fdelconte/RadioInti_M4/README.md

# RadioInti_M4

- [x] checkeado
- [ ] no checked
