fdelconte/RadioInti_M4/HW/Datasheets/Donde comprar los componentes.txt

NE5532D8 -> GM
NE5534D  -> GM

STM32F4Discovery -> Elemon
