fdelconte/RadioInti_M4/HW/Radios_Comunitarias.xls

Comment | Proveedor | Cod. Proveedor | Encapsulado | Designator | Footprint | LibRef | Quantity
10uF 25V T | Elemon | CA3389022K | SMD, TAJ_C | C1, C2, C6, C9, C11, C19, C24, C27, C30, C35, C38, C52, C61, C76, C85, C87 | TAJ_CodeC | CapaPol | 16
0.1uF 25V X7R | Elemon | CA3289100 | 0603 | C3, C4, C7, C8, C13, C14, C20, C21, C26, C31, C32, C37, C55, C57, C79, C81, C88 | C_0603 | Capacitor | 17
1000UF 16V E | Elemon | CA3609183 | TH-10x16 | C5, C10 | Capael_10x16 RAD | CapaPol | 2
330uF 25V T | Elemon | CA3629155 | SMD | C12 | CAPAEL_8x10_SMD | CapaPol | 1
47uF 16V T | Elemon | CA3389030 | TANT_D | C15, C16, C18, C25, C29, C36, C40, C42, C51, C54, C64, C66, C75, C78 | TAJ_CodeD | CapaPol | 14
470pF 50V X7R | Elemon | CA3288970 | 0603 | C17, C23, C28, C34 | C_0603 | Capacitor | 4
10nF 25V X7R | Elemon | CA3289050 | 0603 | C22, C33 | C_0603 | Capacitor | 2
3.3nF 50V X7R | Elemon | CA3279250 | 0805 | C39, C50, C63, C74 | C_0805 | Capacitor | 4
1.2nF 50V COG | Elemon | CA3279110 | 0805 | C41, C46, C53, C59, C65, C70, C77, C83 | C_0805 | Capacitor | 8
1.5nF 50V X7R | Elemon | CA3279140 | 0805 | C43, C58, C67, C82 | C_0805 | Capacitor | 4
1nF 100V X7R | Elemon | CA3289030 | 0603 | C44, C49, C68, C73 | C_0603 | Capacitor | 4
100pF 50V COG | Elemon | CA3288850 | 0603 | C45, C47, C48, C56, C60, C62, C69, C71, C72, C80, C84, C86 | C_0603 | Capacitor | 12
Bornera P2.54mm | Elemon | Consultar |  | CN1 | Conn_3_1 | Conn_3_1 | 1
AC3FDZ Amphenol |  |  |  | CN2, CN3 | XLR_Ext | XLR_hembra | 2
Conector 5x1 P2.54mm | Elemon | CO4901010 |  | CN4 | Conn_5_1 | Conn_5_1 | 1
MBR140SFT1G | Elemon | DI1351306 | SOD-123FL | D1, D2, D5 | SOD-123FL | Schottky | 3
TVS 36V 600W | Elemon | DI120SMDDIK36AT3G | SMB | D4, D6 | SMB | TVS | 2
IND EMI SUP FILT HAS | Elemon | FI151VINBOB600 | DSS6_S | F1, F2 | EMIFIL_DSS6_S | EMI_3T | 2
Jumper 2x1 | Elemon | CO4921360 |  | JP1, JP2, JP3, JP4 | Conn_2_1 | Jumper 2x1 | 4
Jumper 3x1 | Elemon | CO4921360 |  | JP5 | Conn_3_1 | Jumper 3x1 | 1
CHIP FERRITE BEAD | Elemon | FI1488955 | 0805 | L1 | C_0805 | Inductor | 1
JK60-300 | Elemon | TE2627680 | TH | P1, P2 | JK60-300 | Poly | 2
Hembra BNC a chasis | Elemon | Consultar |  | P3, P4 | BNC_Ext | BNC | 2
10R 5% 1/16W | Elemon | RS3866060 | 0603 | R3, R4, R5, R6 | R_0603 | Resistor | 4
4K7 5% 1/16W | Elemon | RS3866225 | 0603 | R7, R8, R14, R15, R23, R24, R37, R38 | R_0603 | Resistor | 8
47K 5% 1/16W | Elemon | RS3866285 | 0603 | R9, R16 | R_0603 | Resistor | 2
3K3 5% 1/10W | Elemon | RS3896215 | 0805 | R10, R11, R17, R18 | R_0805 | Resistor | 4
1K 5% 1/16W | Elemon | RS3866185 | 0603 | R12, R13, R19, R20 | R_0603 | Resistor | 4
1K8 5% 1/10W | Elemon | RS3896200 | 0805 | R21, R22, R26, R28, R29, R31, R35, R36, R40, R42, R43, R45 | R_0805 | Resistor | 12
1K2 5% 1/10W | Elemon | RS3896190 | 0805 | R25, R30, R39, R44, R54, R65, R71, R82 | R_0805 | Resistor | 8
22R 5% 1/16W | Elemon | RS3866085 | 0603 | R27, R33, R41, R47 | R_0603 | Resistor | 4
10K 5% 1/16W | Elemon | RS3866245 | 0603 | R32, R34, R46, R48, R51, R63, R68, R80 | R_0603 | Resistor | 8
330R 5% 1/10W | Elemon | RS3896155 | 0805 | R49, R61, R66, R78 | R_0805 | Resistor | 4
180R 5% 1/10W | Elemon | RS3896140 | 0805 | R50, R62, R67, R79 | R_0805 | Resistor | 4
680R 5% 1/10W | Elemon | RS3896175 | 0805 | R52, R64, R69, R81 | R_0805 | Resistor | 4
560R 5% 1/10W | Elemon | RS3896170 | 0805 | R53, R60, R70, R77 | R_0805 | Resistor | 4
150R 5% 1/10W | Elemon | RS3896135 | 0805 | R55, R57, R72, R74 | R_0805 | Resistor | 4
470R 5% 1/16W | Elemon | RS3866165 | 0603 | R56, R58, R73, R75 | R_0603 | Resistor | 4
100R 5% 1/16W | Elemon | RS3866125 | 0603 | R59, R76 | R_0603 | Resistor | 2
LM1117DTX-3.3/NOPB | Elemon | CI2707214D | DPAK, SMD | U1, U4 | DPAK | LM1117 | 2
LM7805CDT | Elemon | CI2707459 | TO-220-3 | U2, U3 | TO-220-3 | LM7805 | 2
TL072 | SYC | TL072-SMD | SOIC8 | U5, U6, U7, U8, U9, U10, U11, U12 | SOIC8 | NE5532D8 | 8
STM32F4Discovery | Elemon | MC6350305 | TH | U13 | STM32F4DISCOVERY | STM32F4Discovery | 1
AK4621 | Ya esta | Ya esta | SMD | U14 | AK4621 | AK4621 | 1
