fdelconte/RadioInti_M4/HW/Radios_Comunitarias.PDF

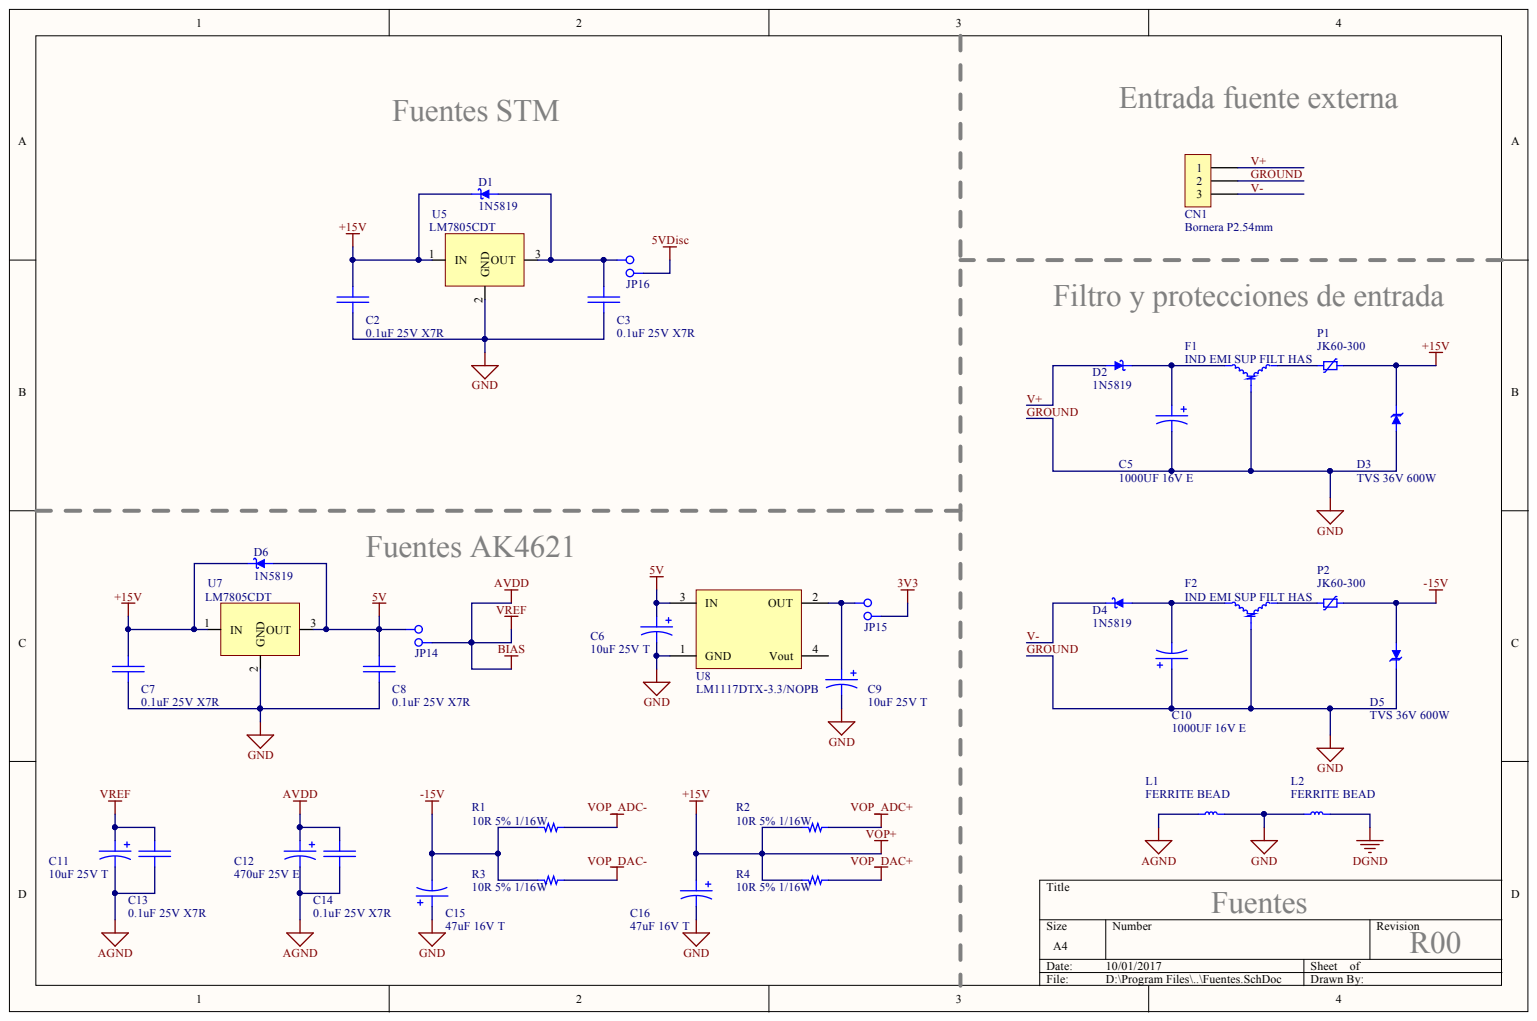
[picture p3: page 1]

Entrada fuente externa Fuentes STM

Filtro y protecciones de entrada

IND EMI SUP FILT HAS

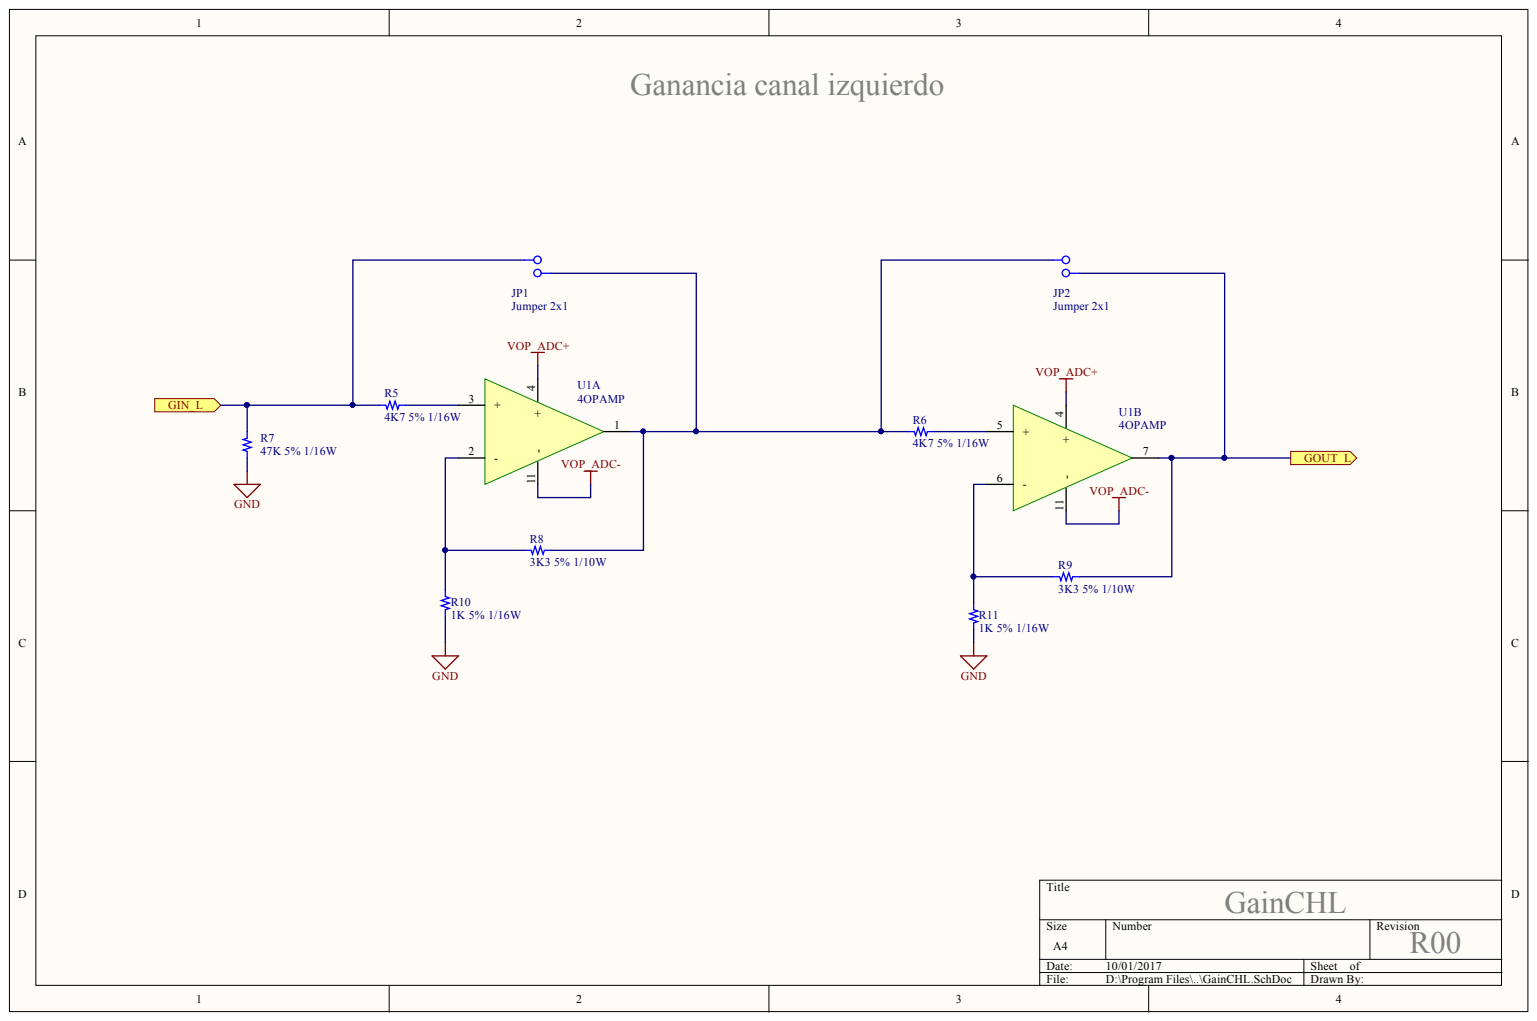
[picture p4: page 2]

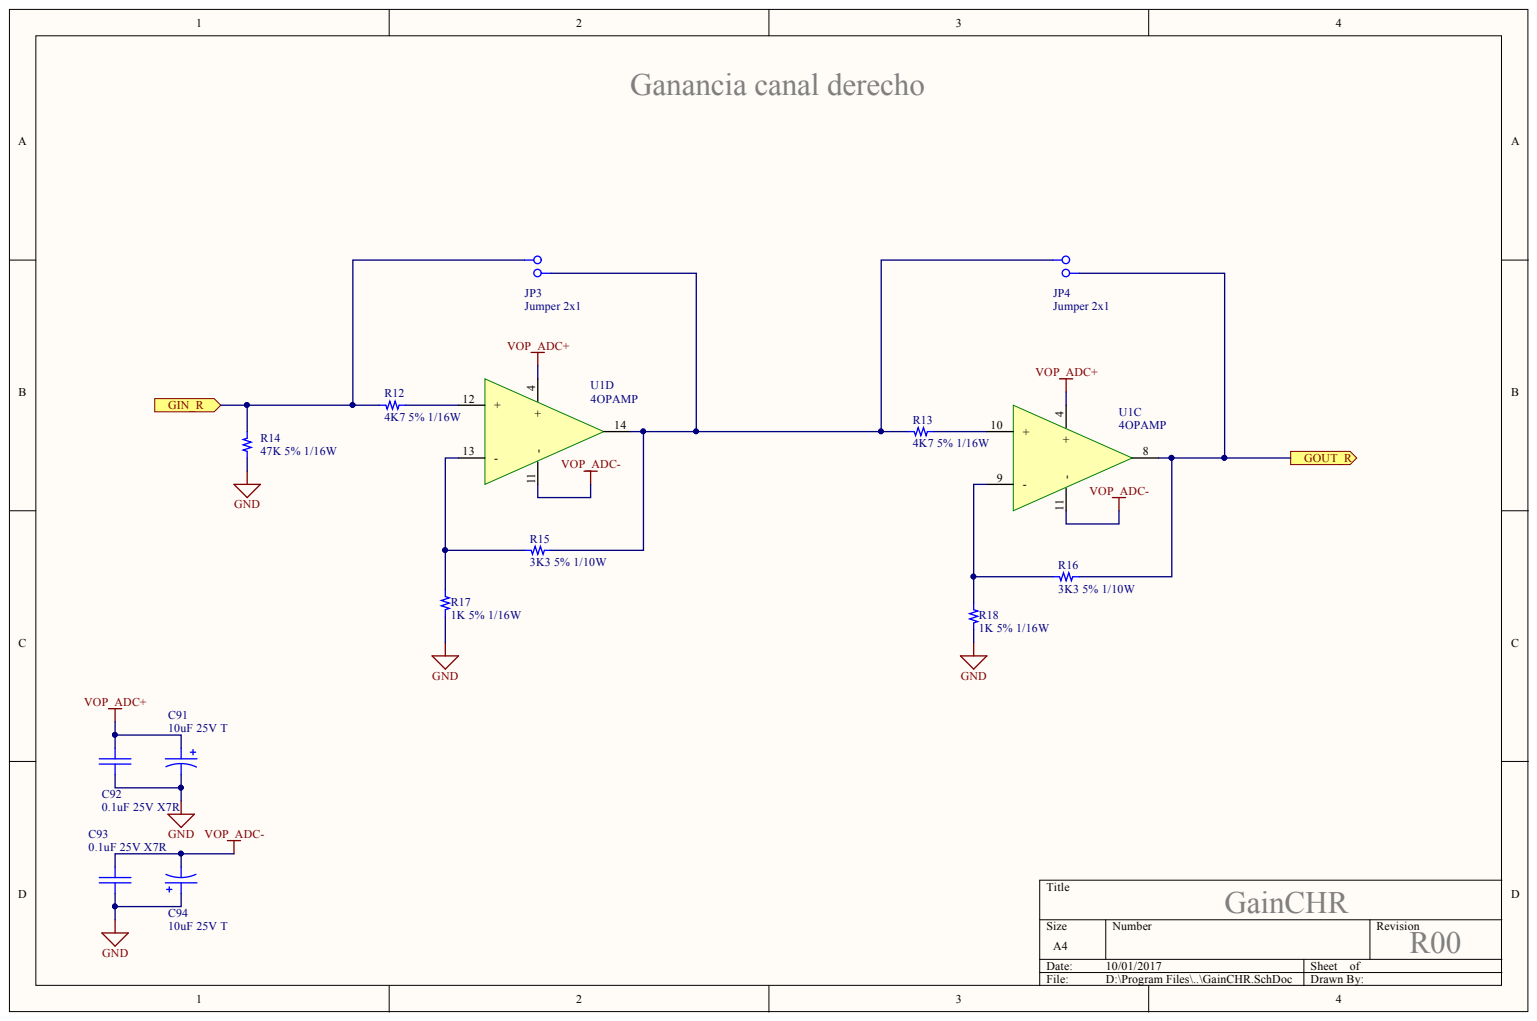
[picture p5: page 3]

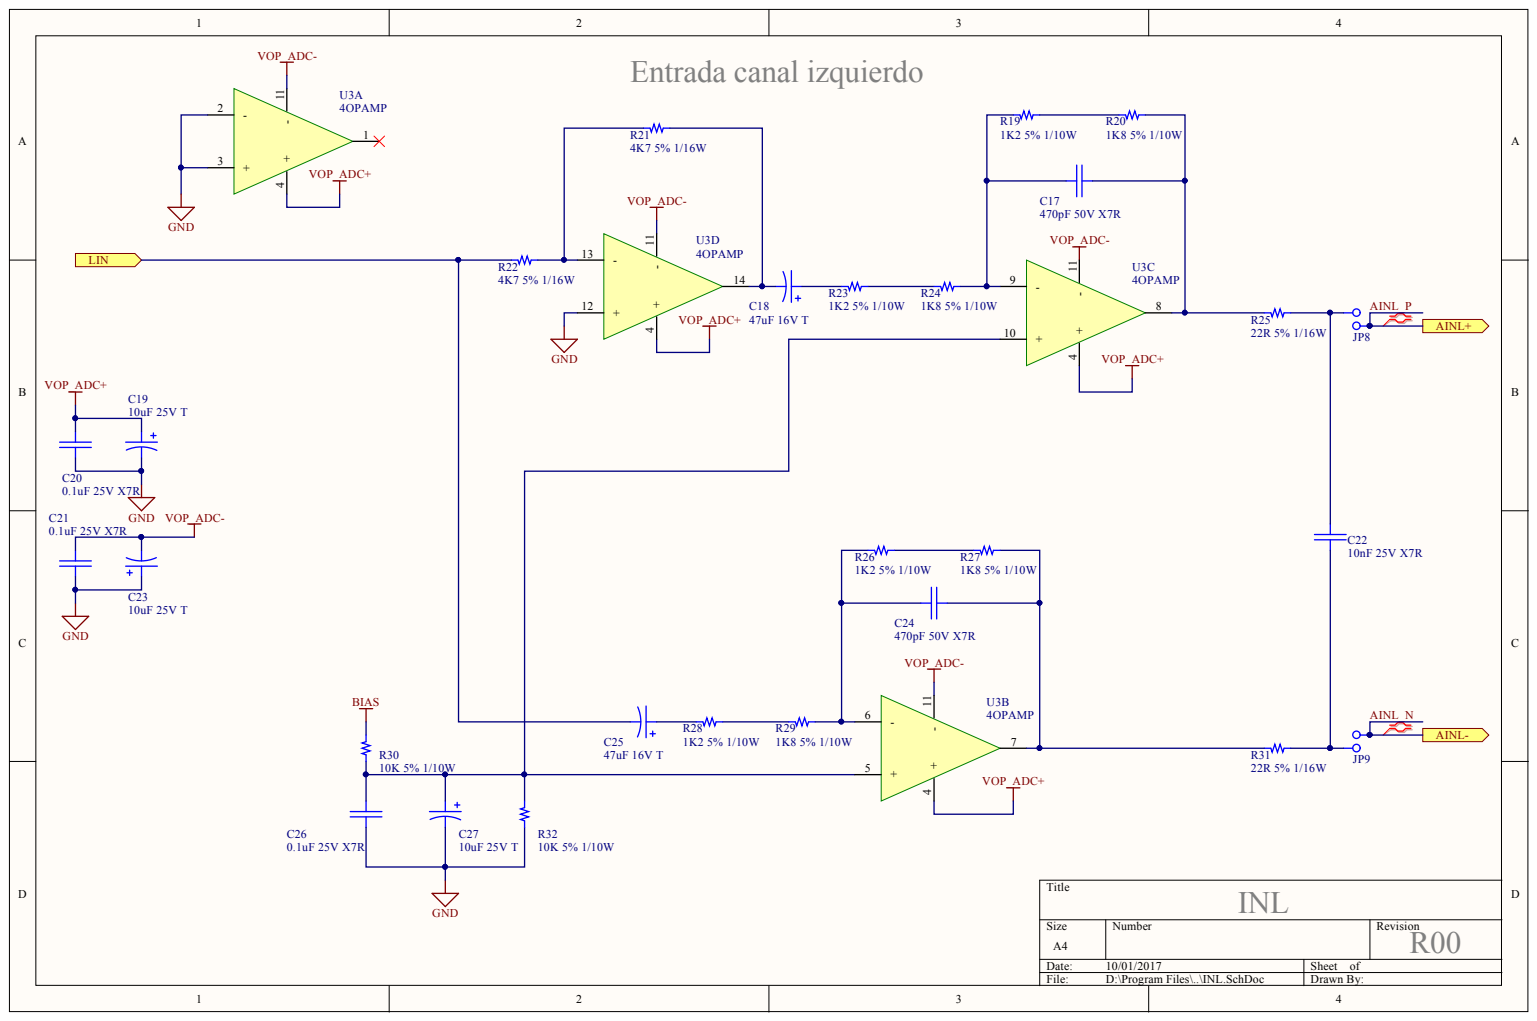
[picture p6: page 4]

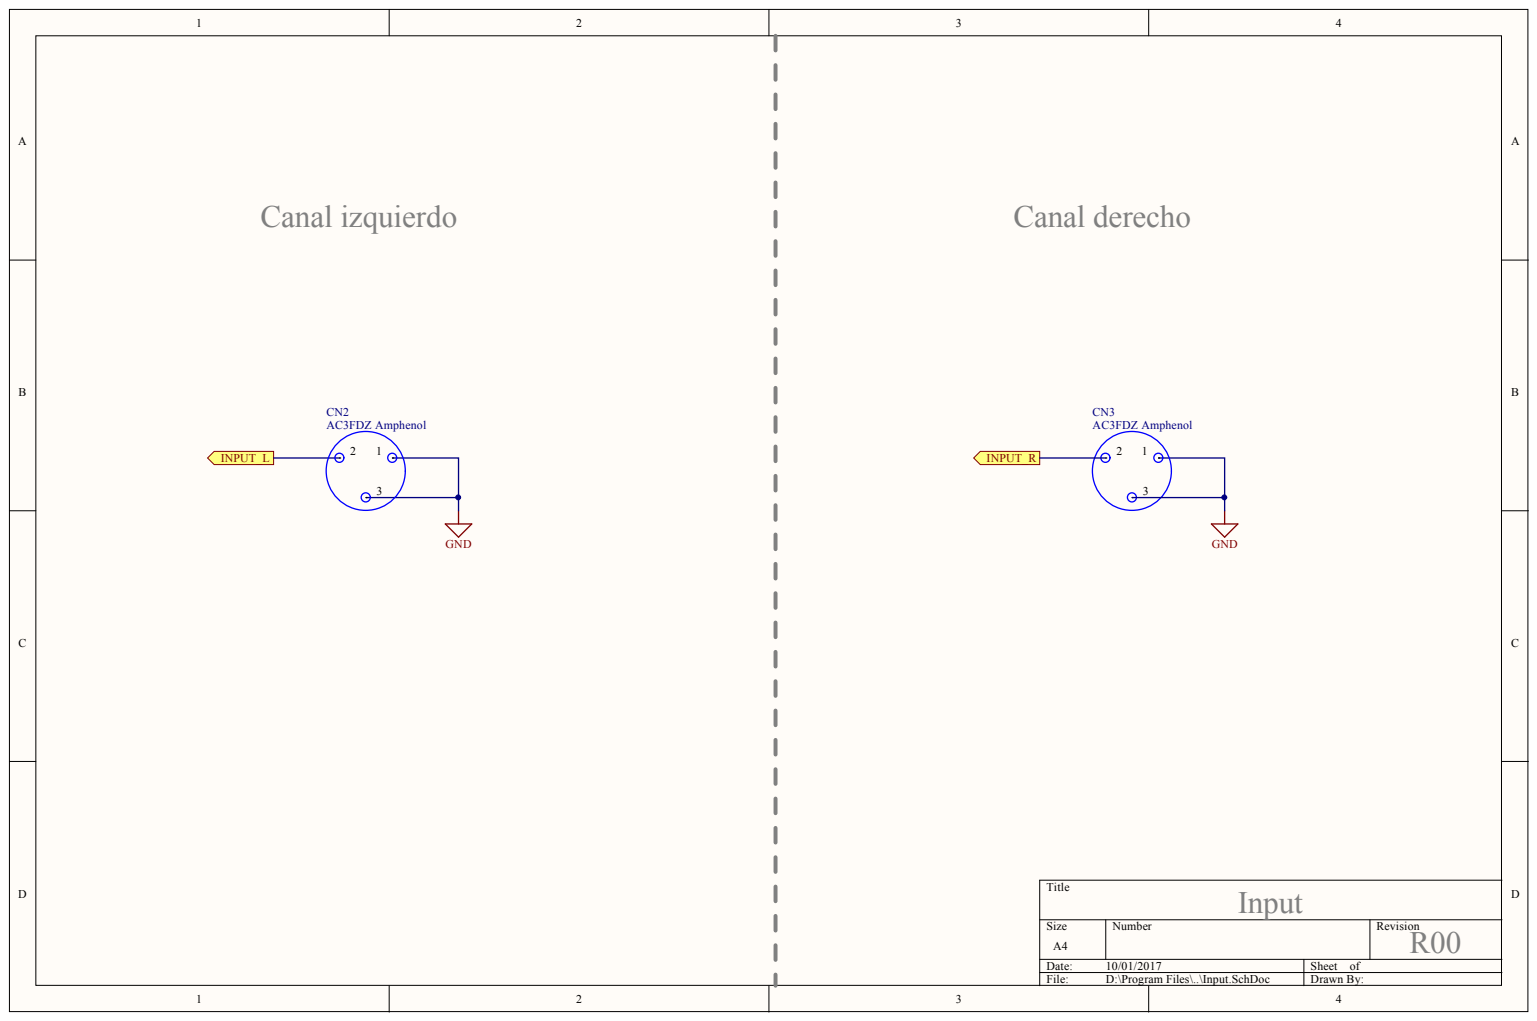
[picture p7: page 5]

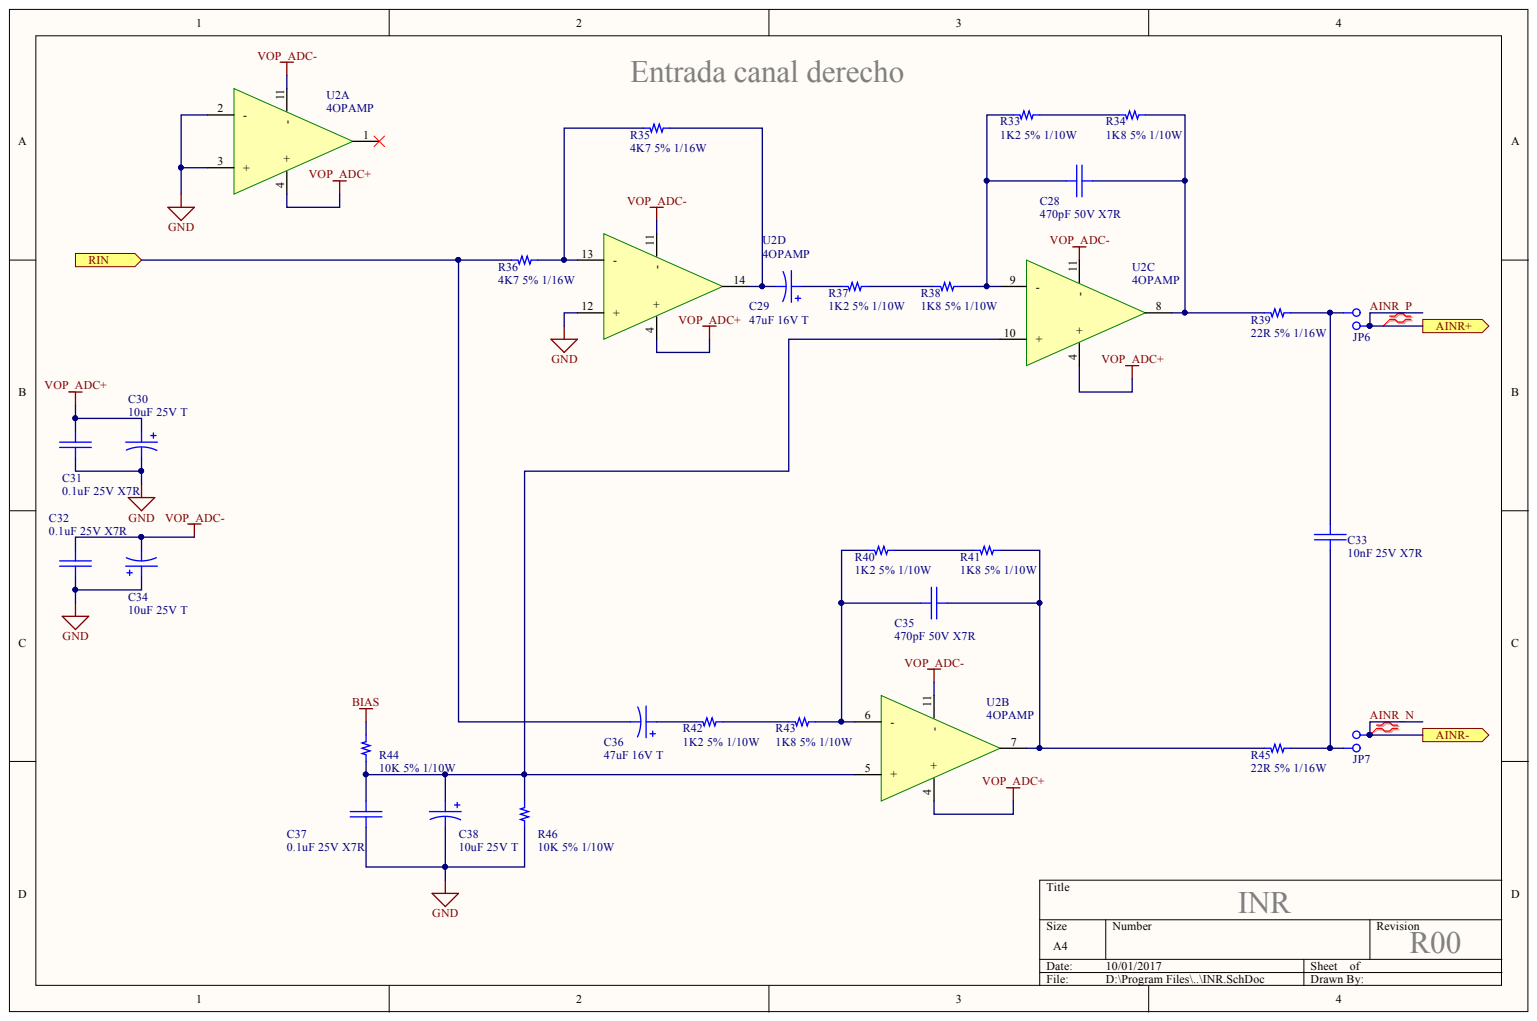
[picture p8: page 6]

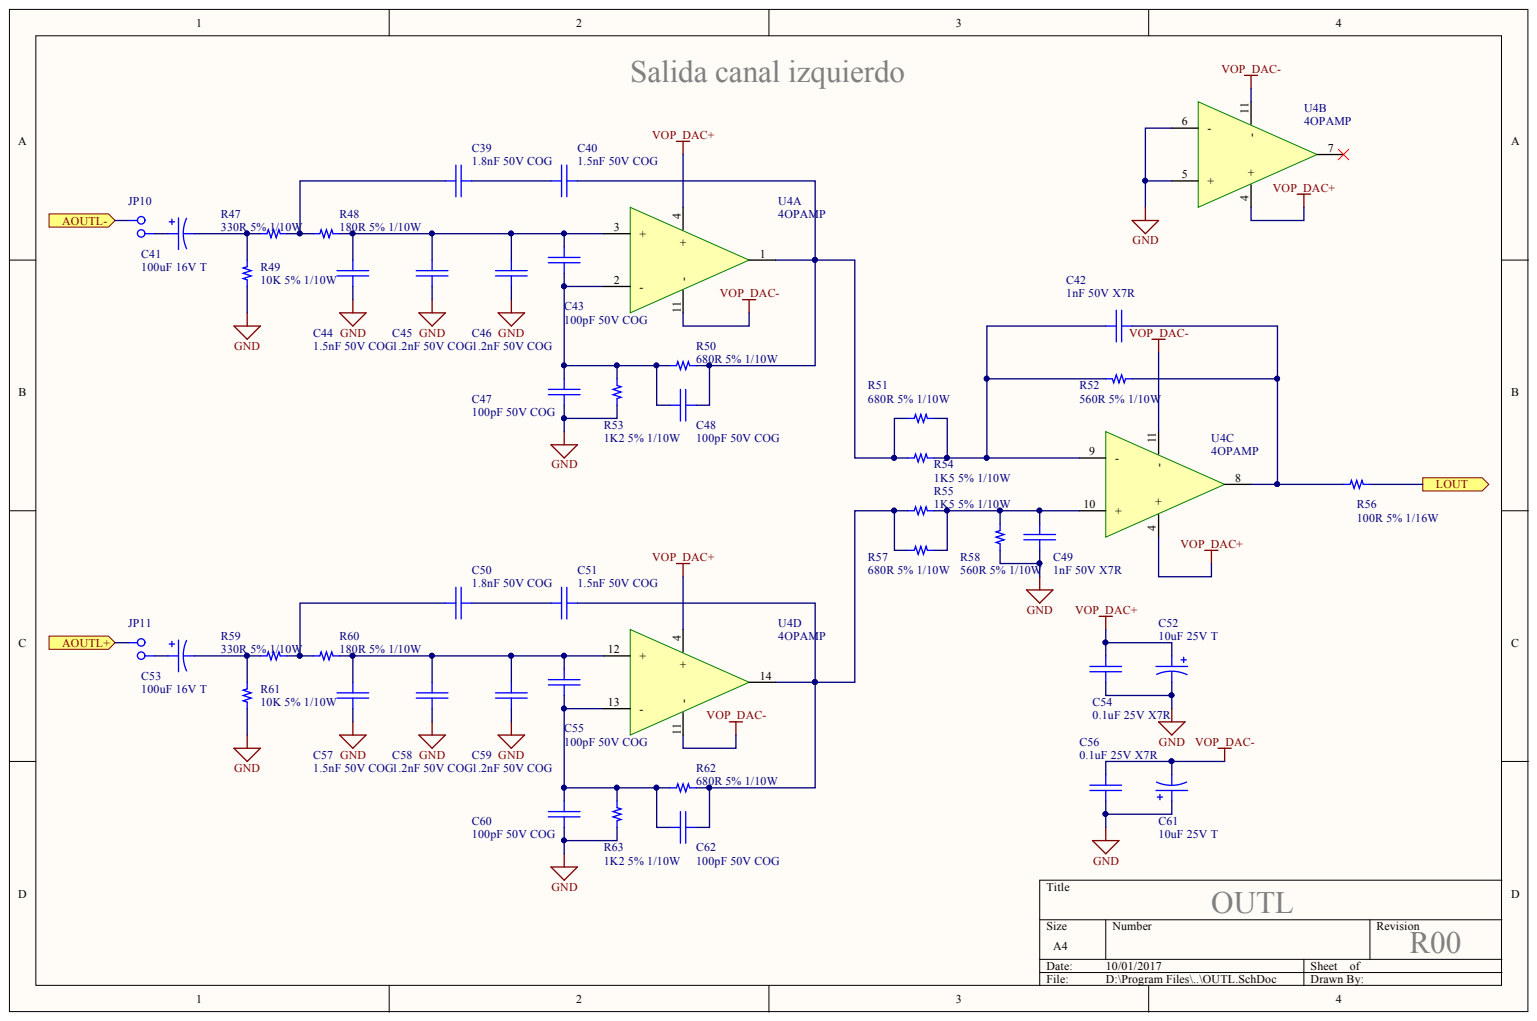
[picture p9: page 7]

VOP_DAC-% 1 / 1 0 W

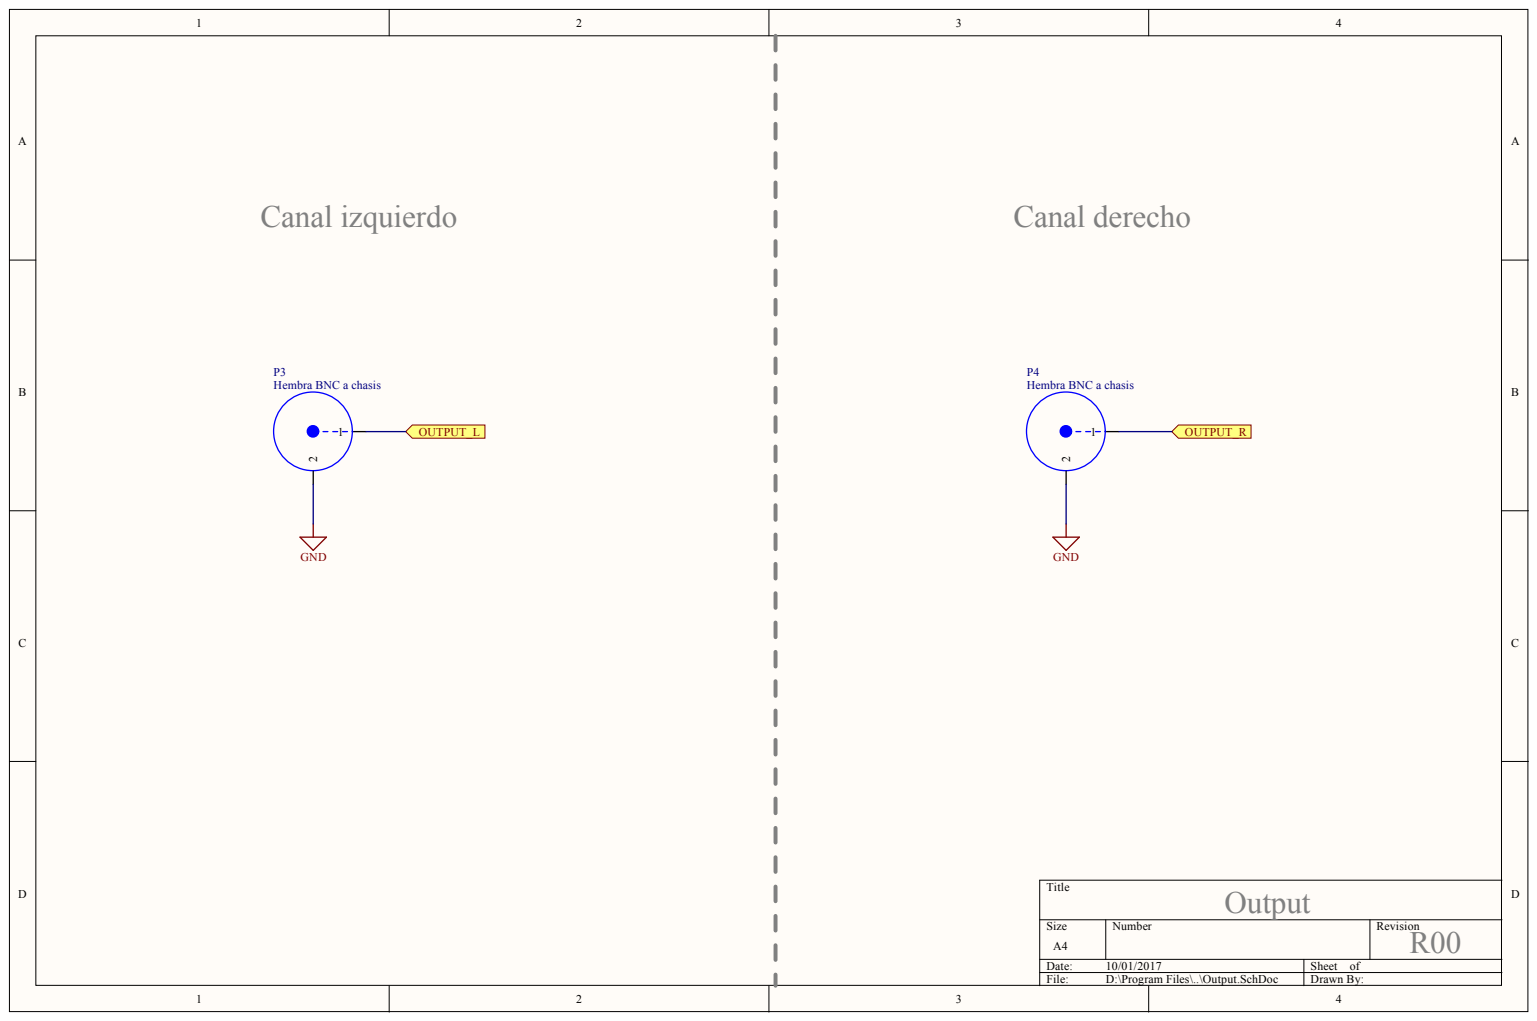
[picture p10: page 8]

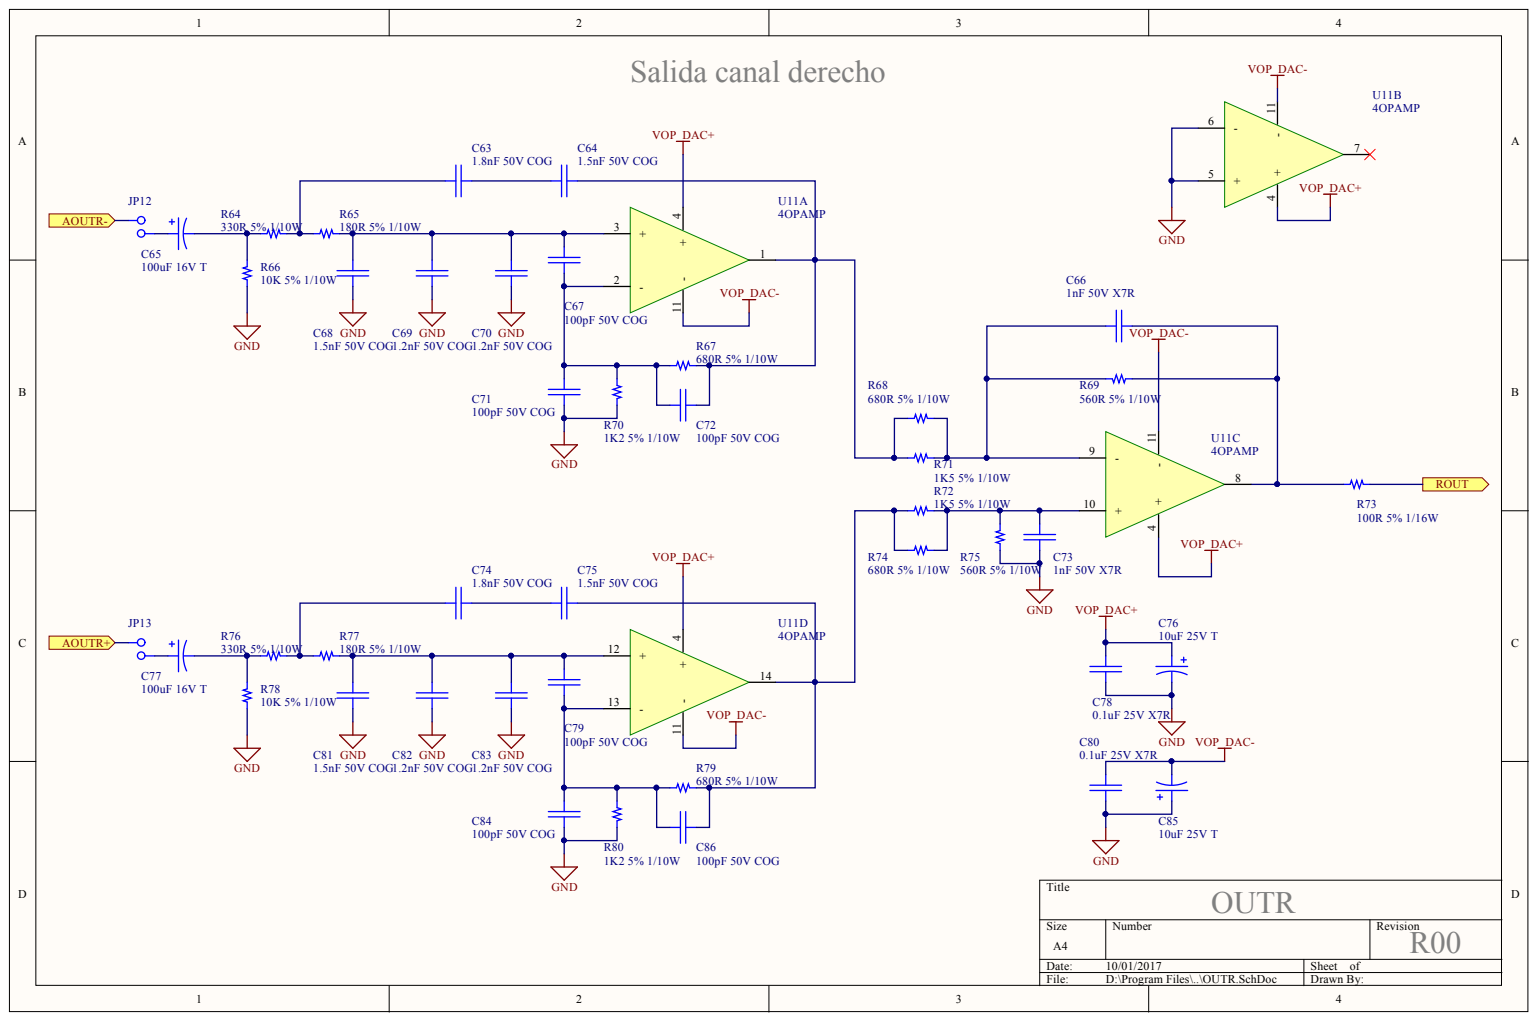
[picture p11: page 9]

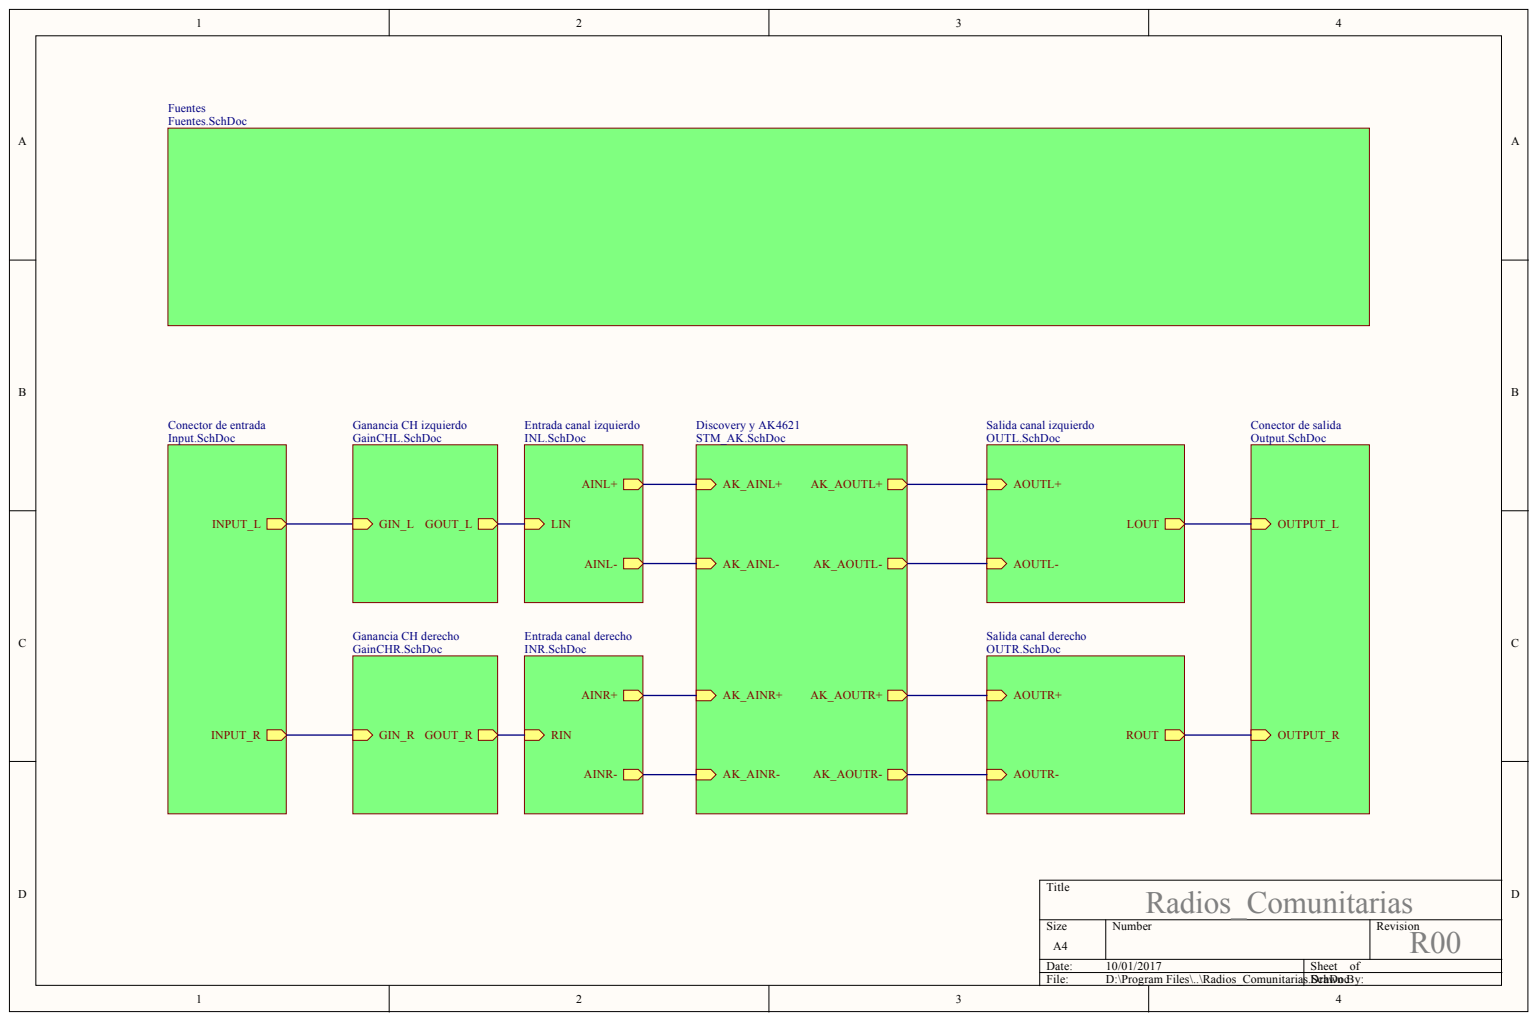
[picture p12: page 10]

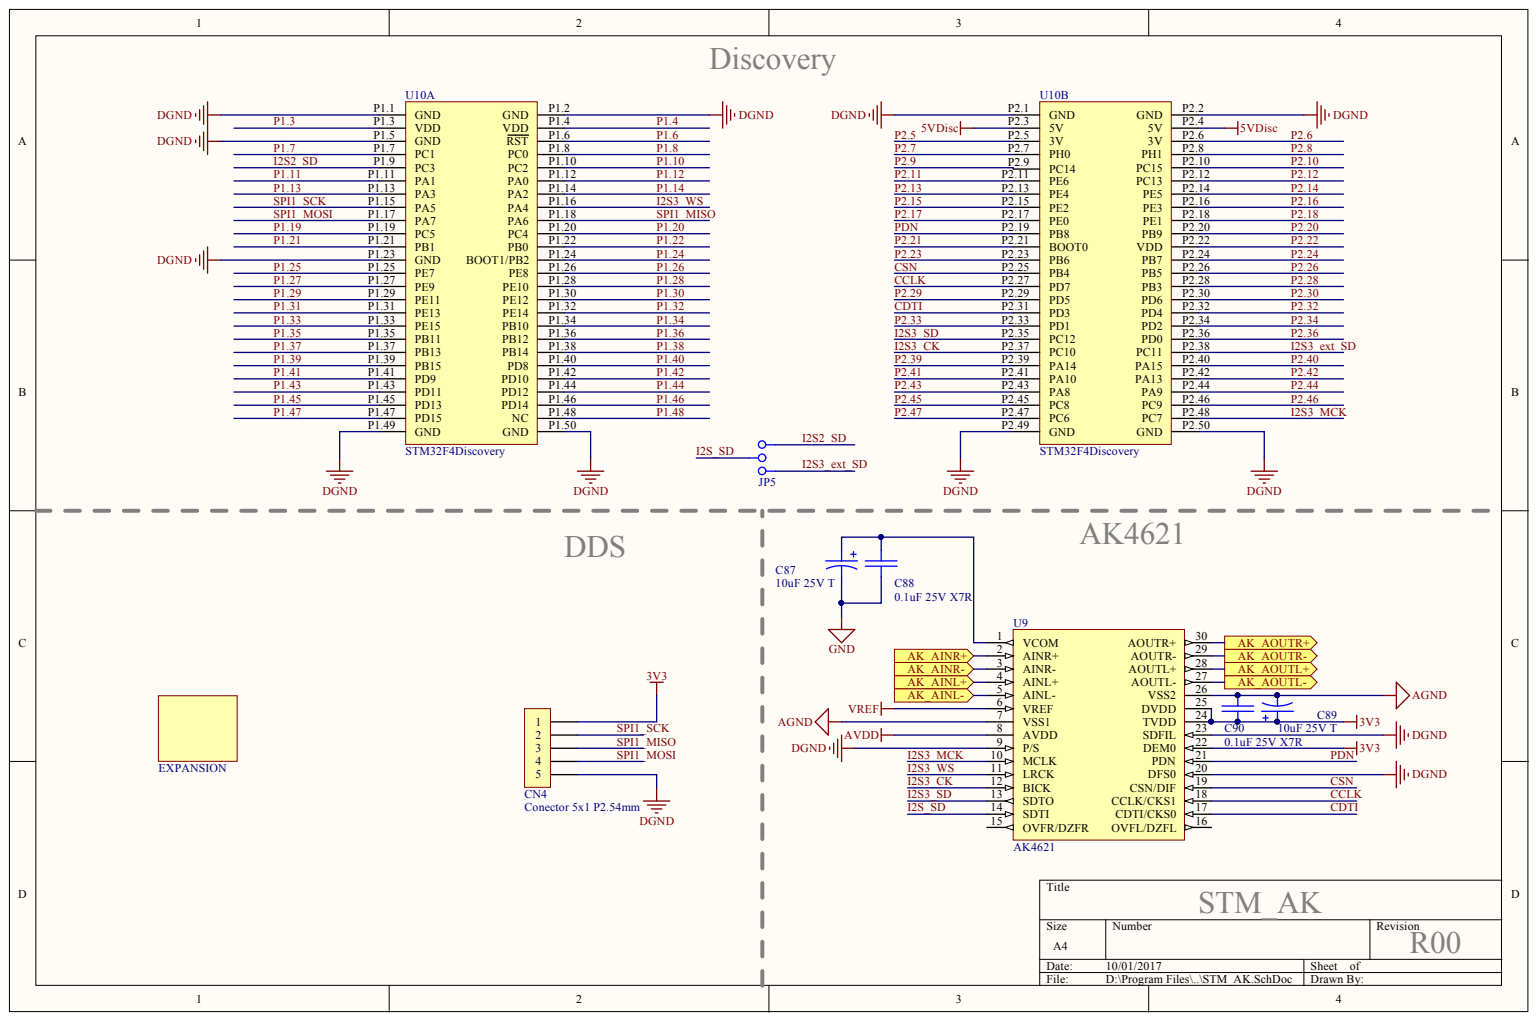
[picture p13: page 11]

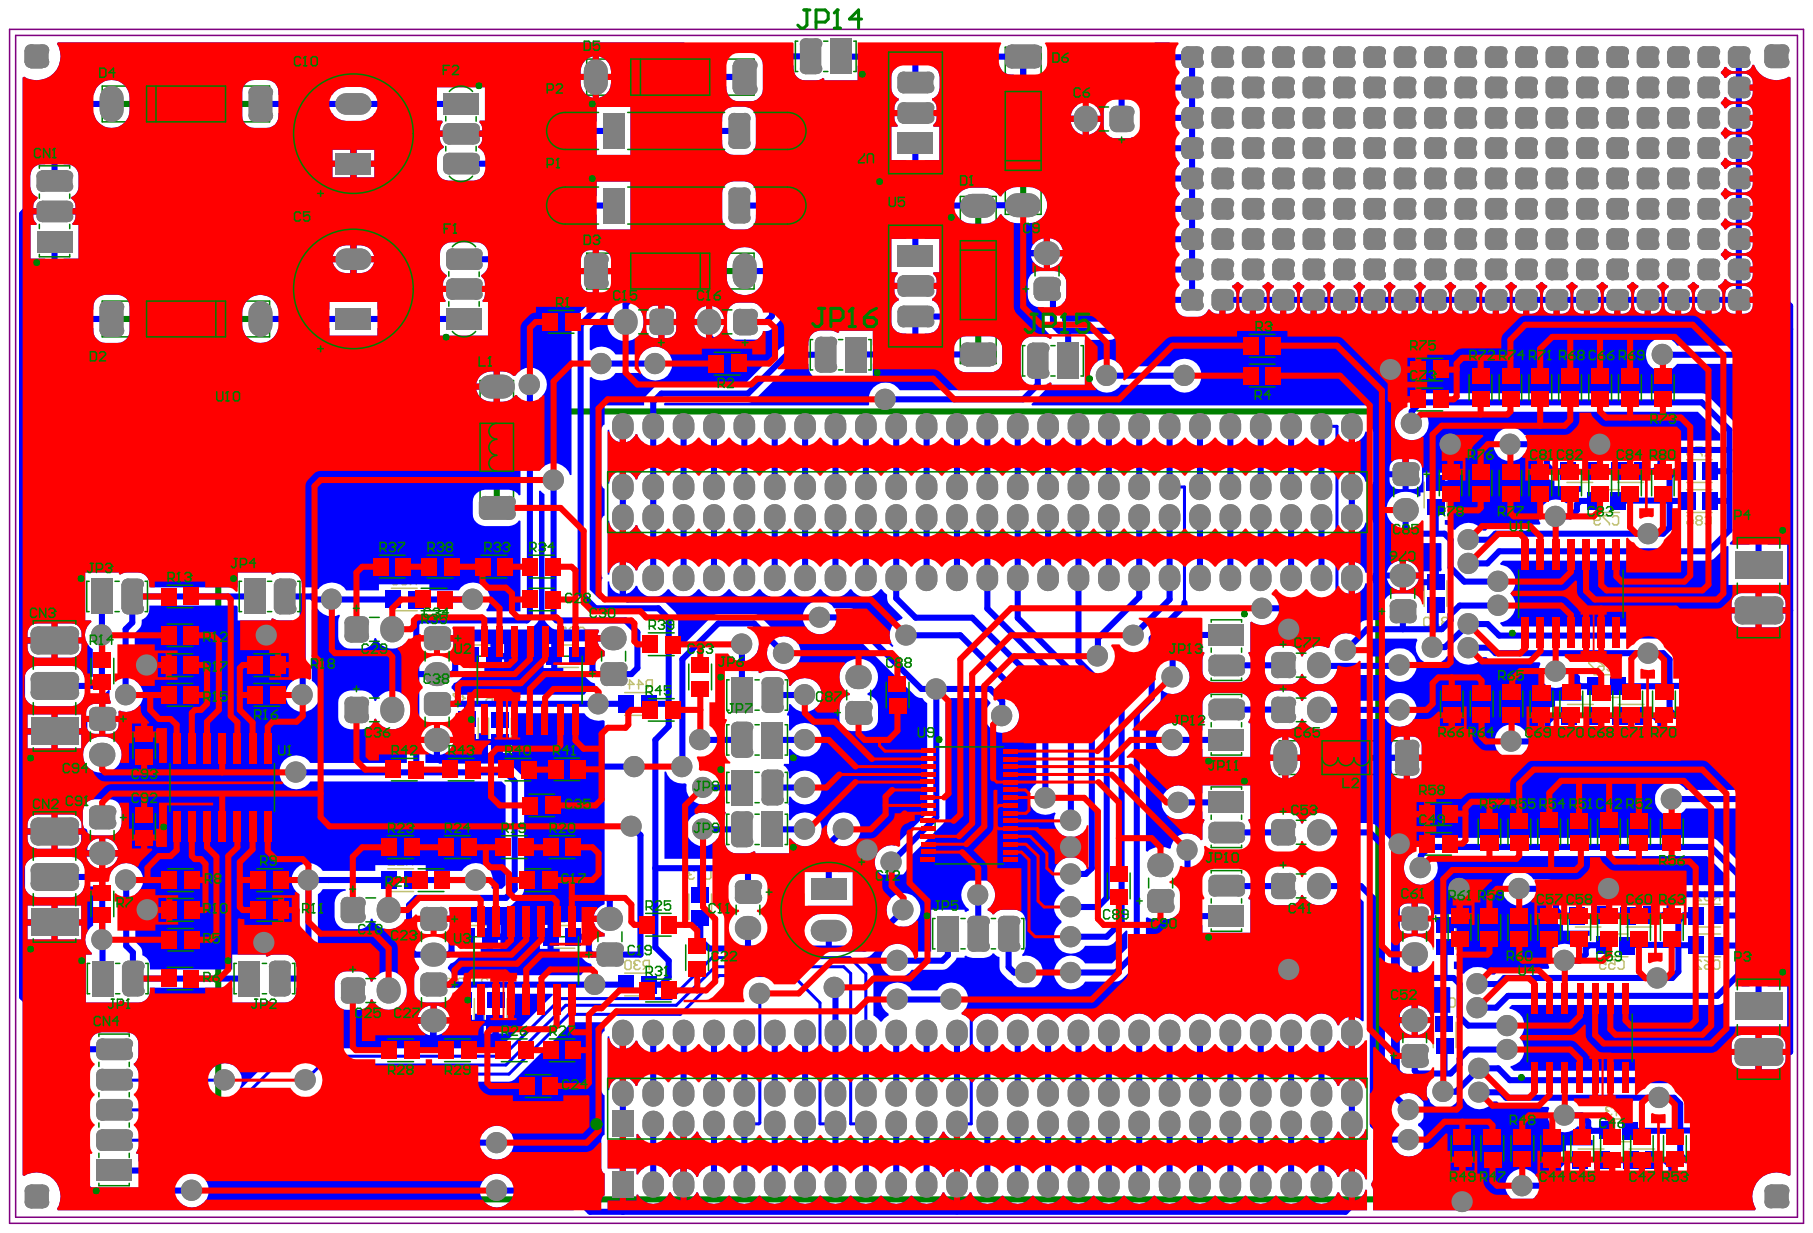
[picture p14: page 12]
