fdelconte/RadioInti_M4/HW/Project Outputs for Radios_Comunitarias/Job1.PDF

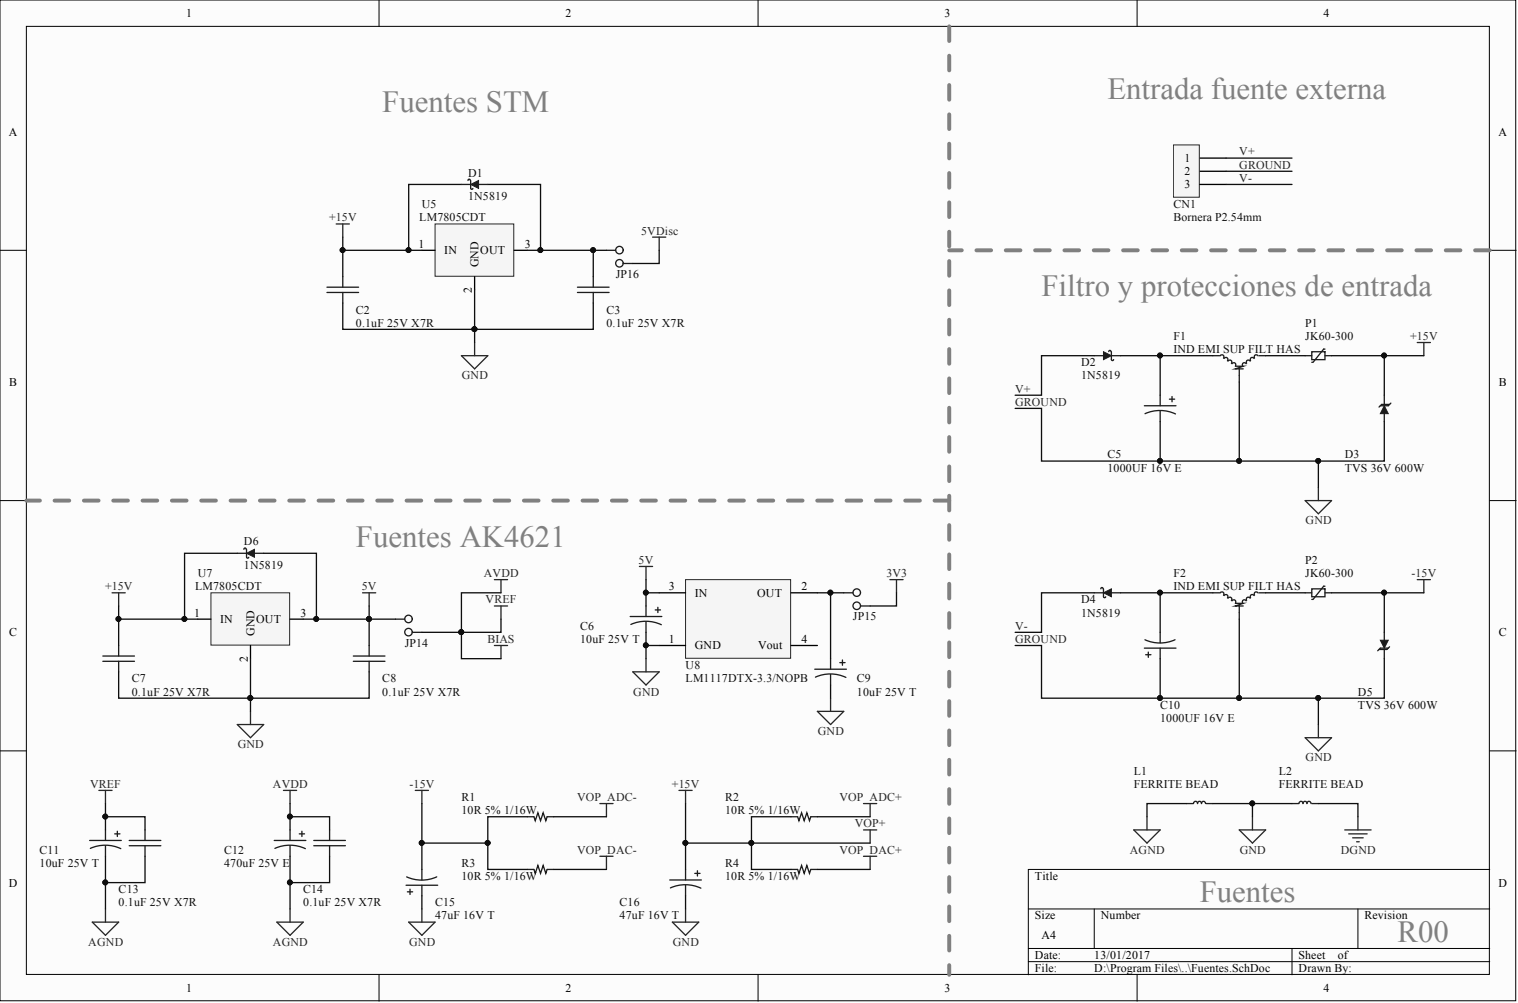
[picture p15: page 1]

Entrada fuente externa Fuentes STM

Filtro y protecciones de entrada

IND EMI SUP FILT HAS

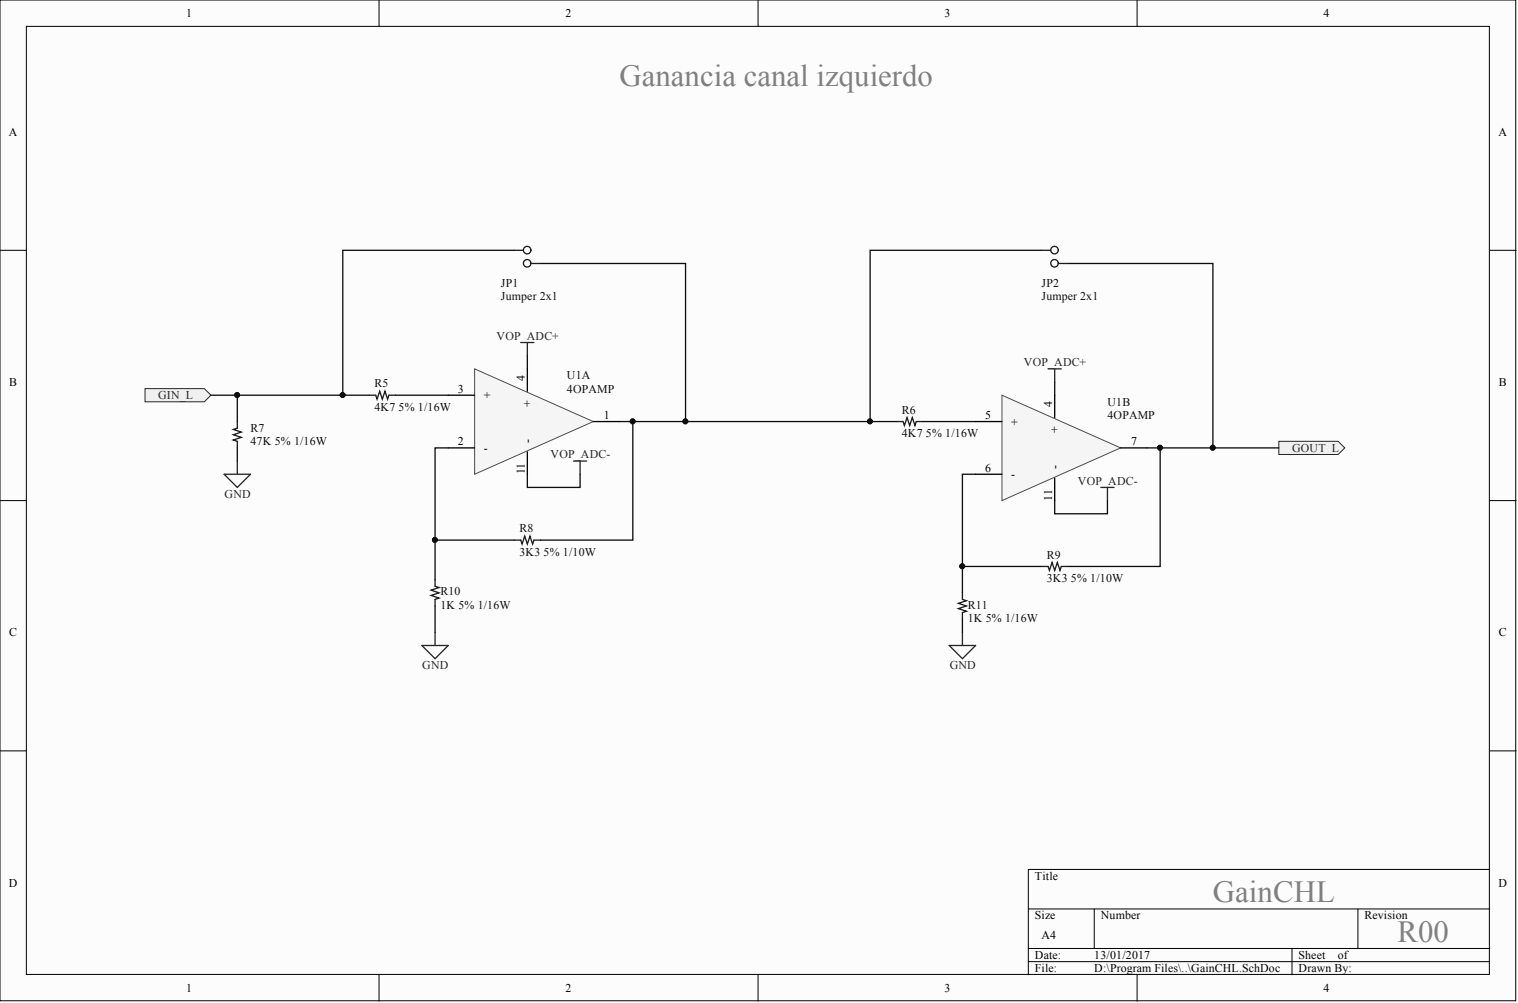
[picture p16: page 2]

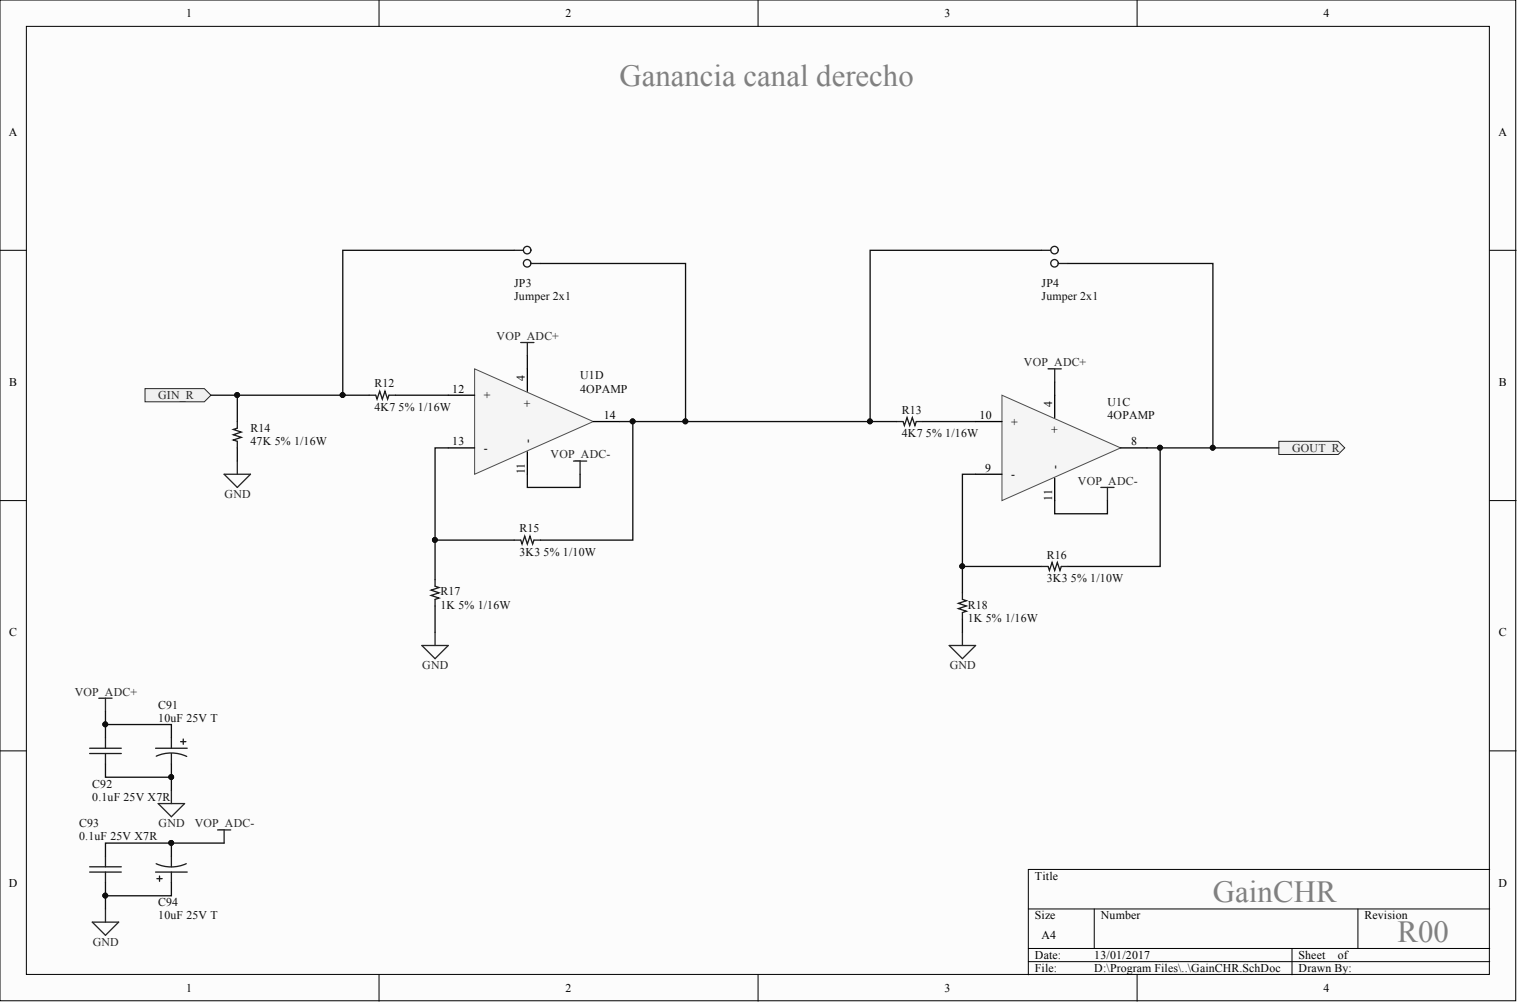
[picture p17: page 3]

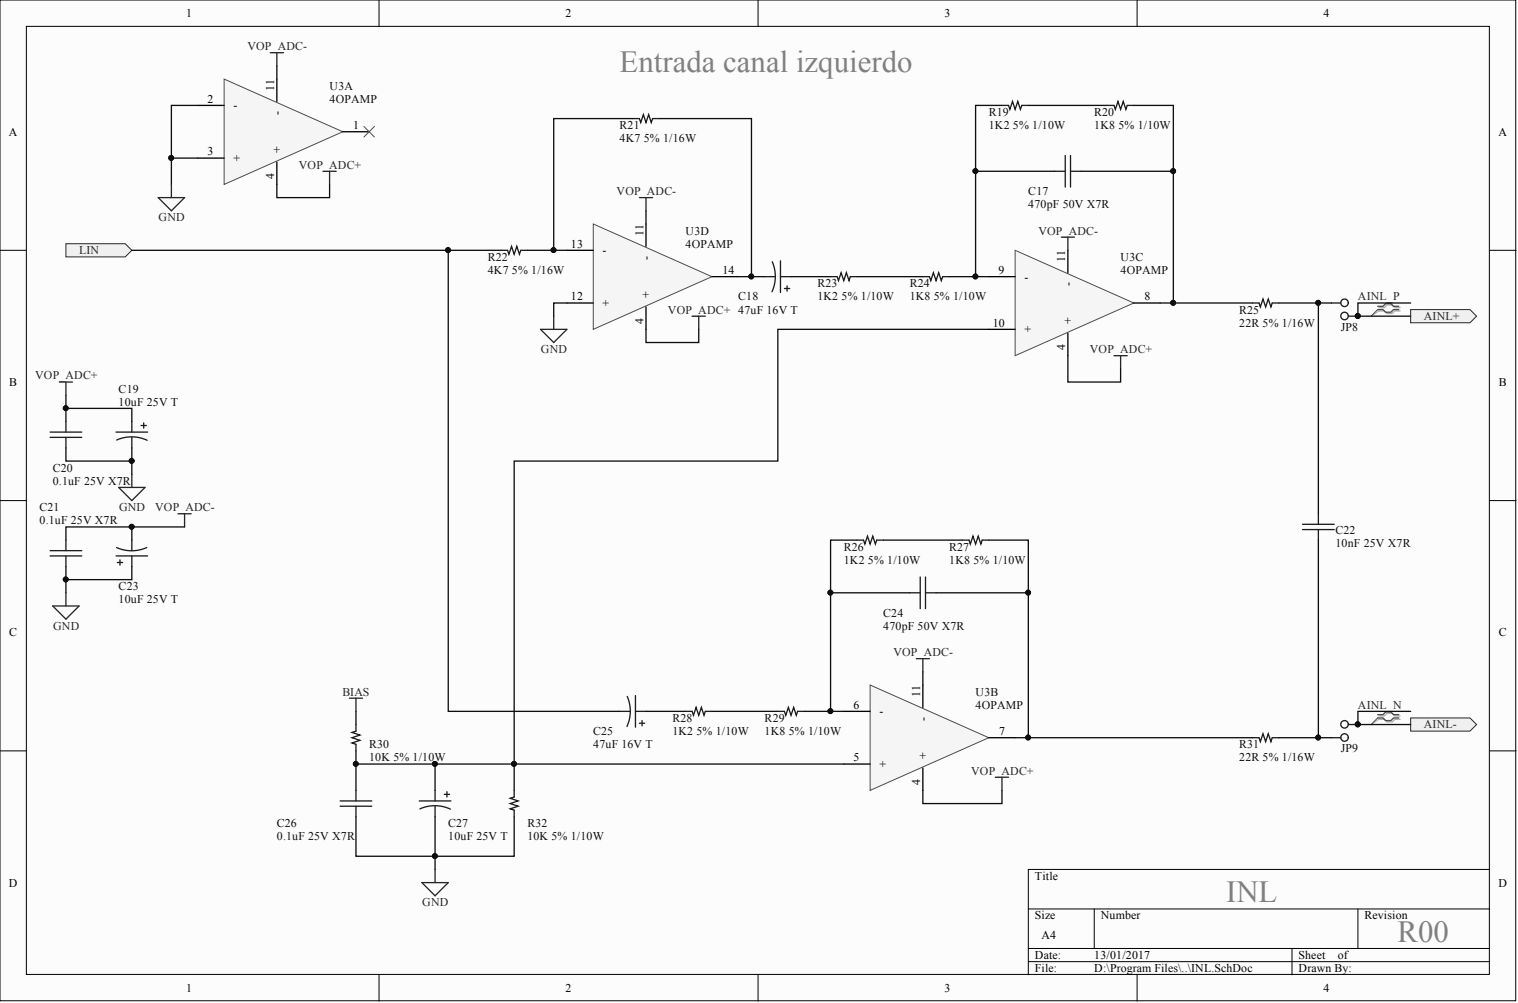
[picture p18: page 4]

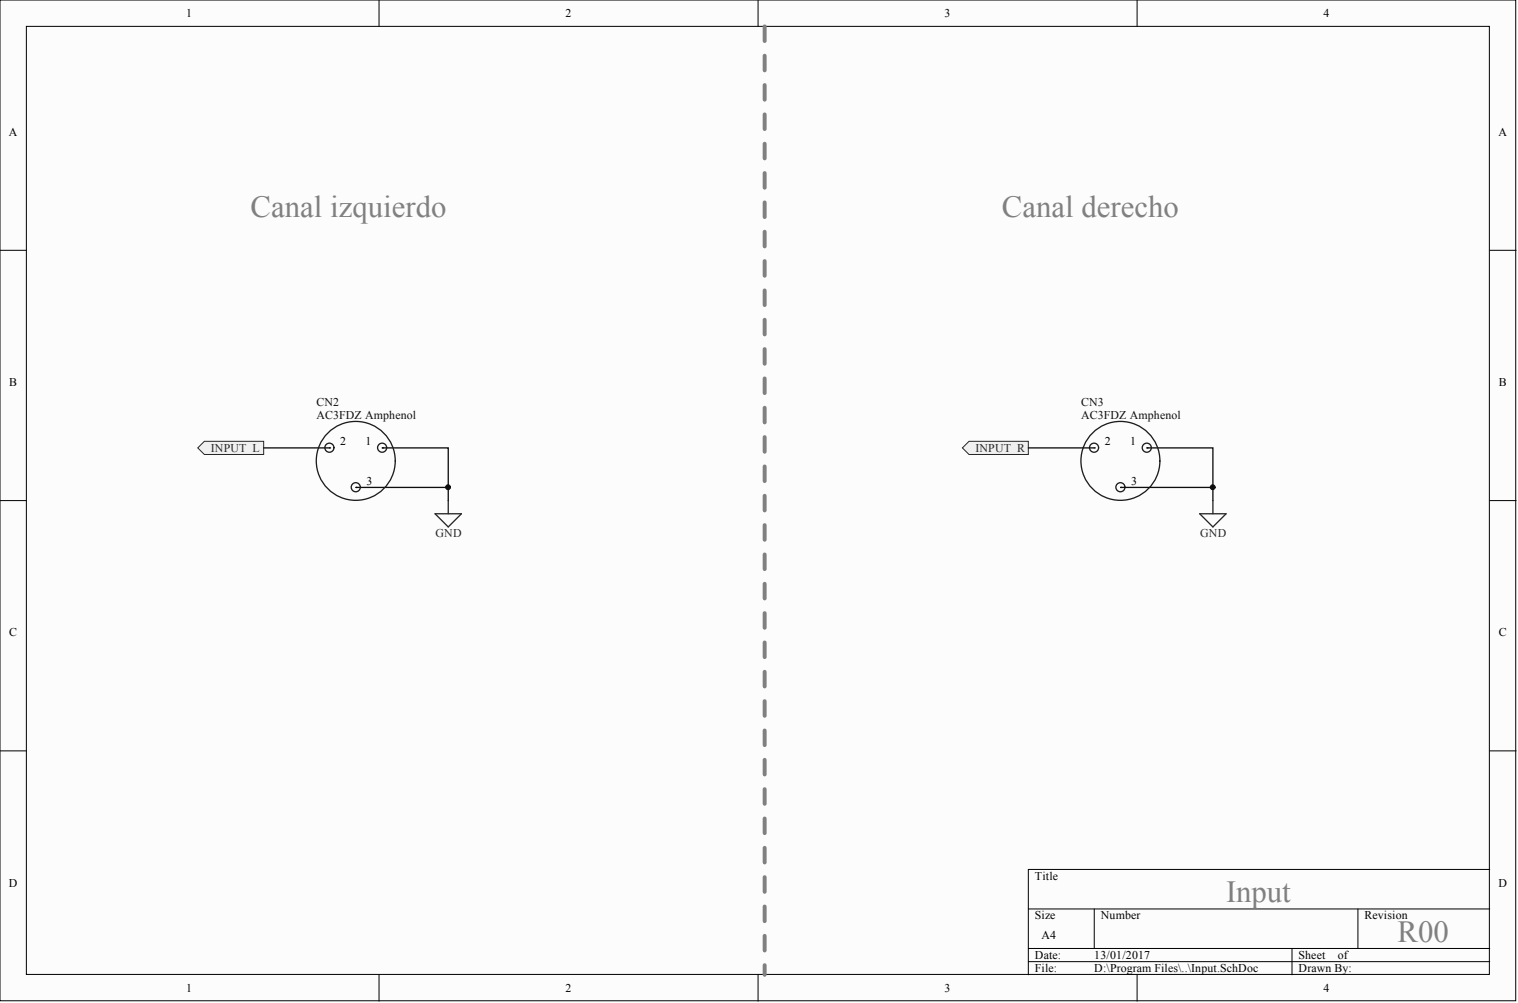
[picture p19: page 5]

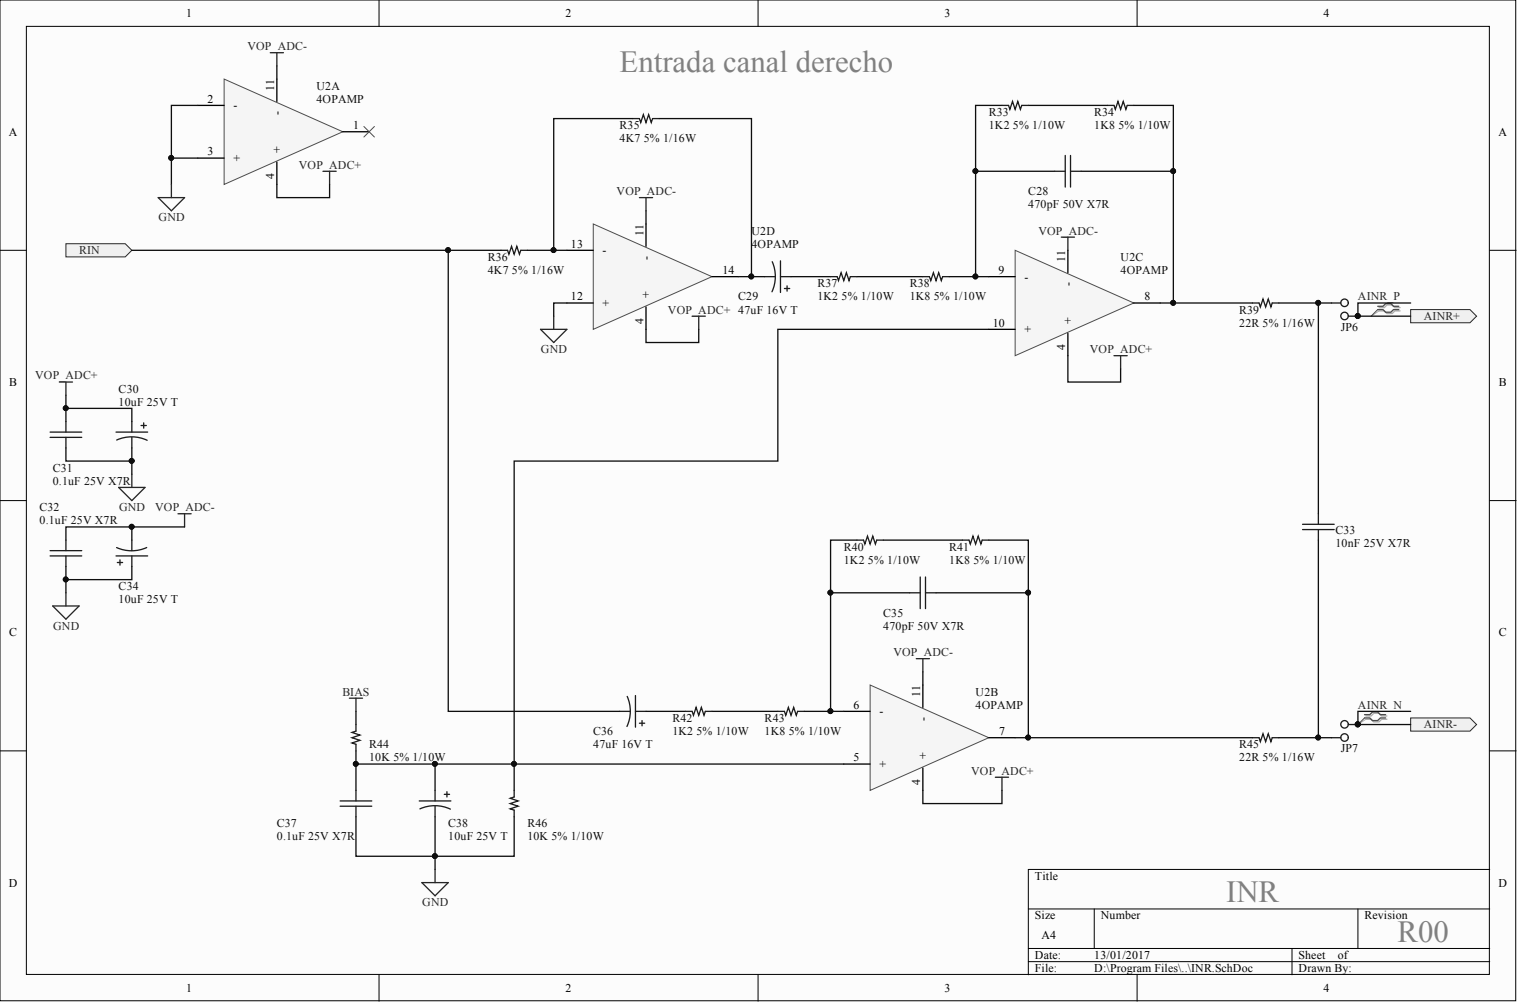
[picture p20: page 6]

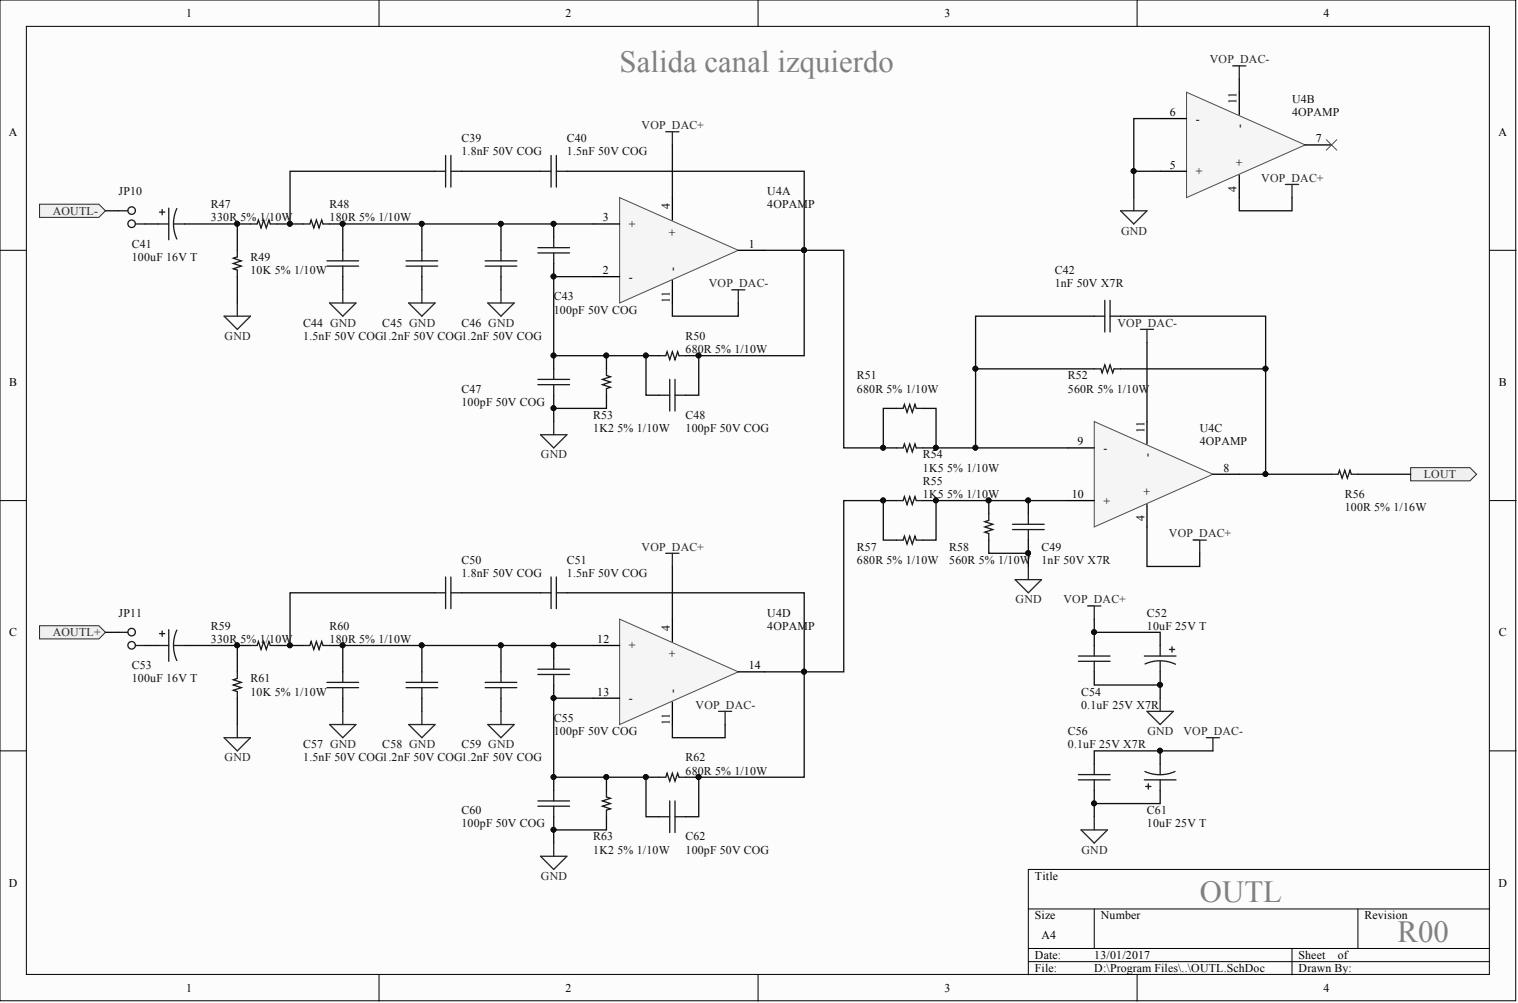
[picture p21: page 7]

VOP_DAC-% 1 / 1 0 W

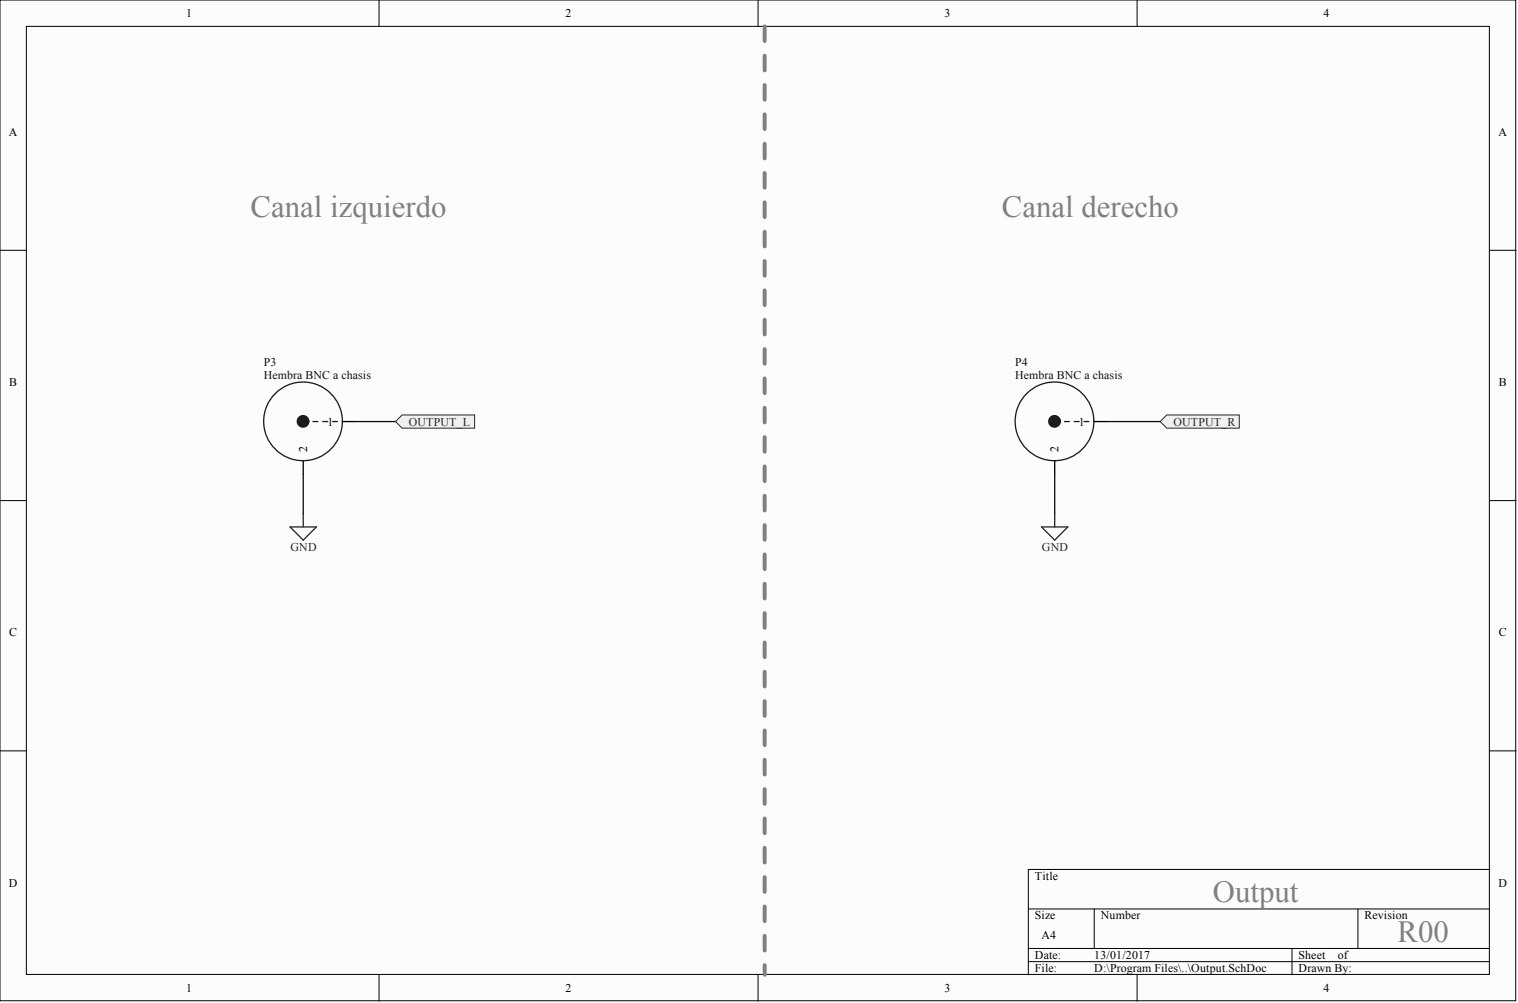
[picture p22: page 8]

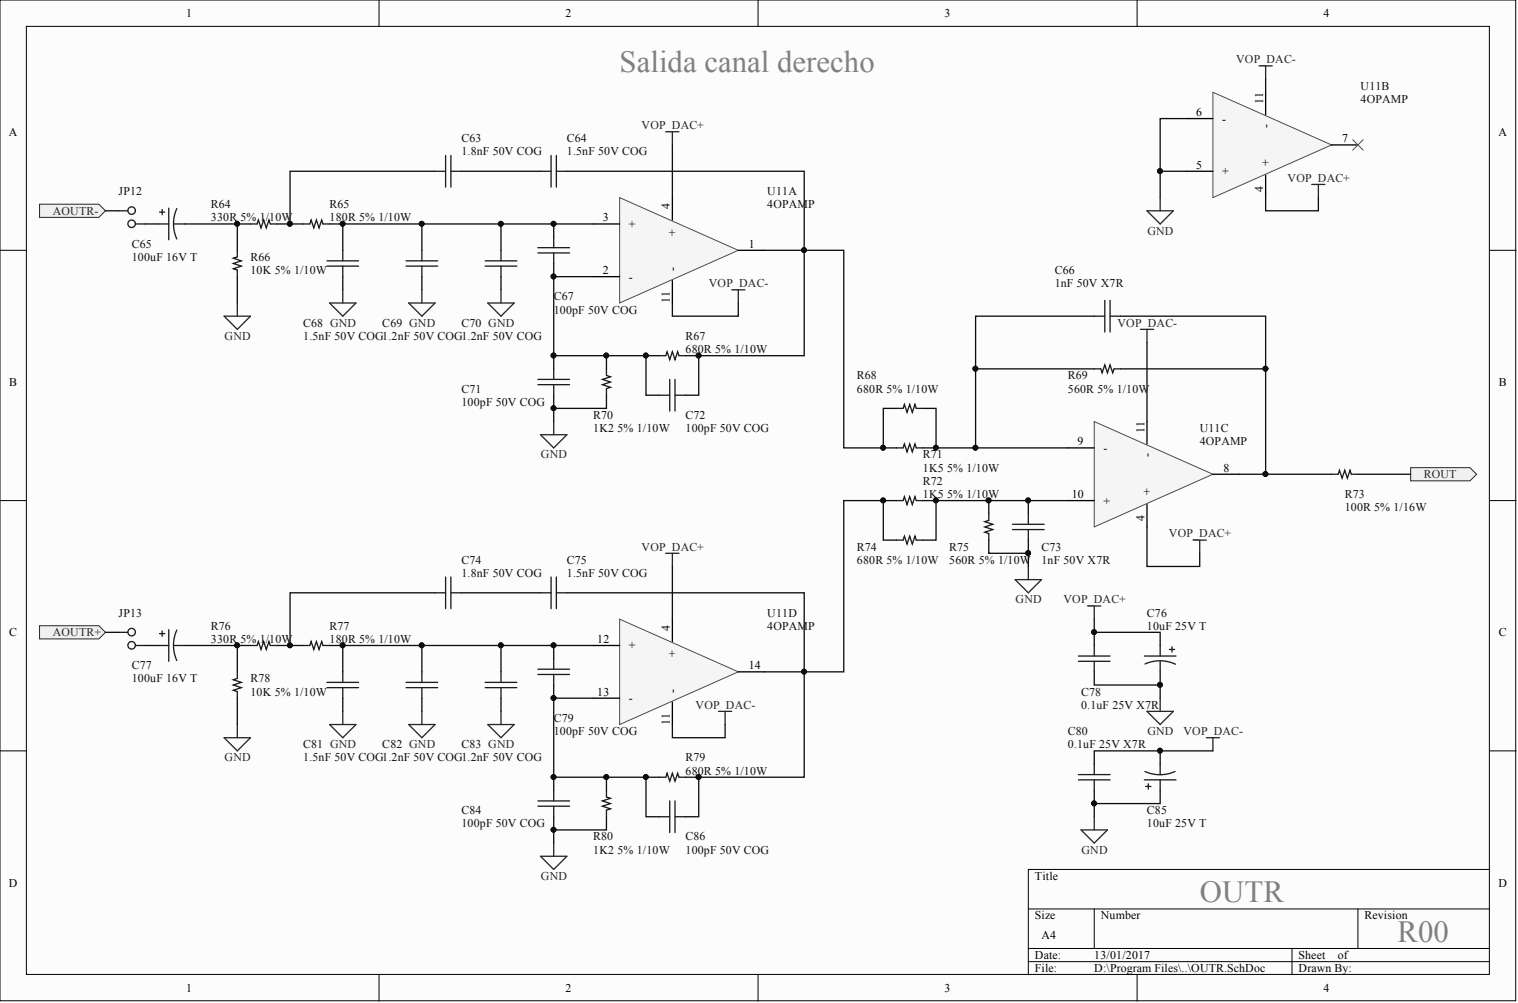
[picture p23: page 9]

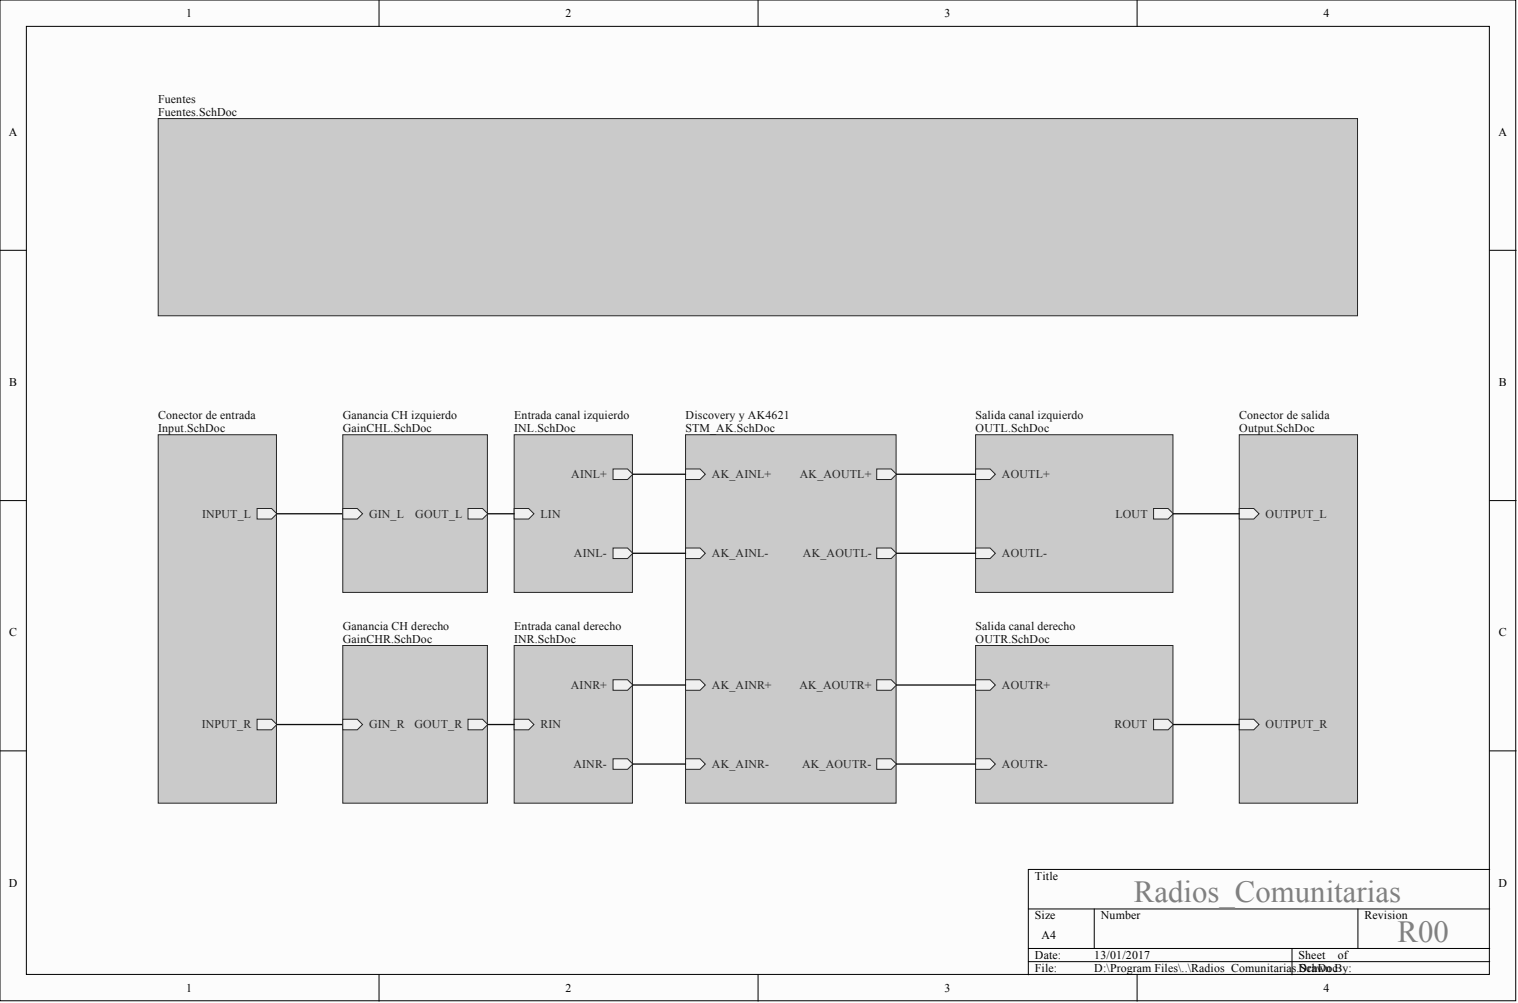
[picture p24: page 10]

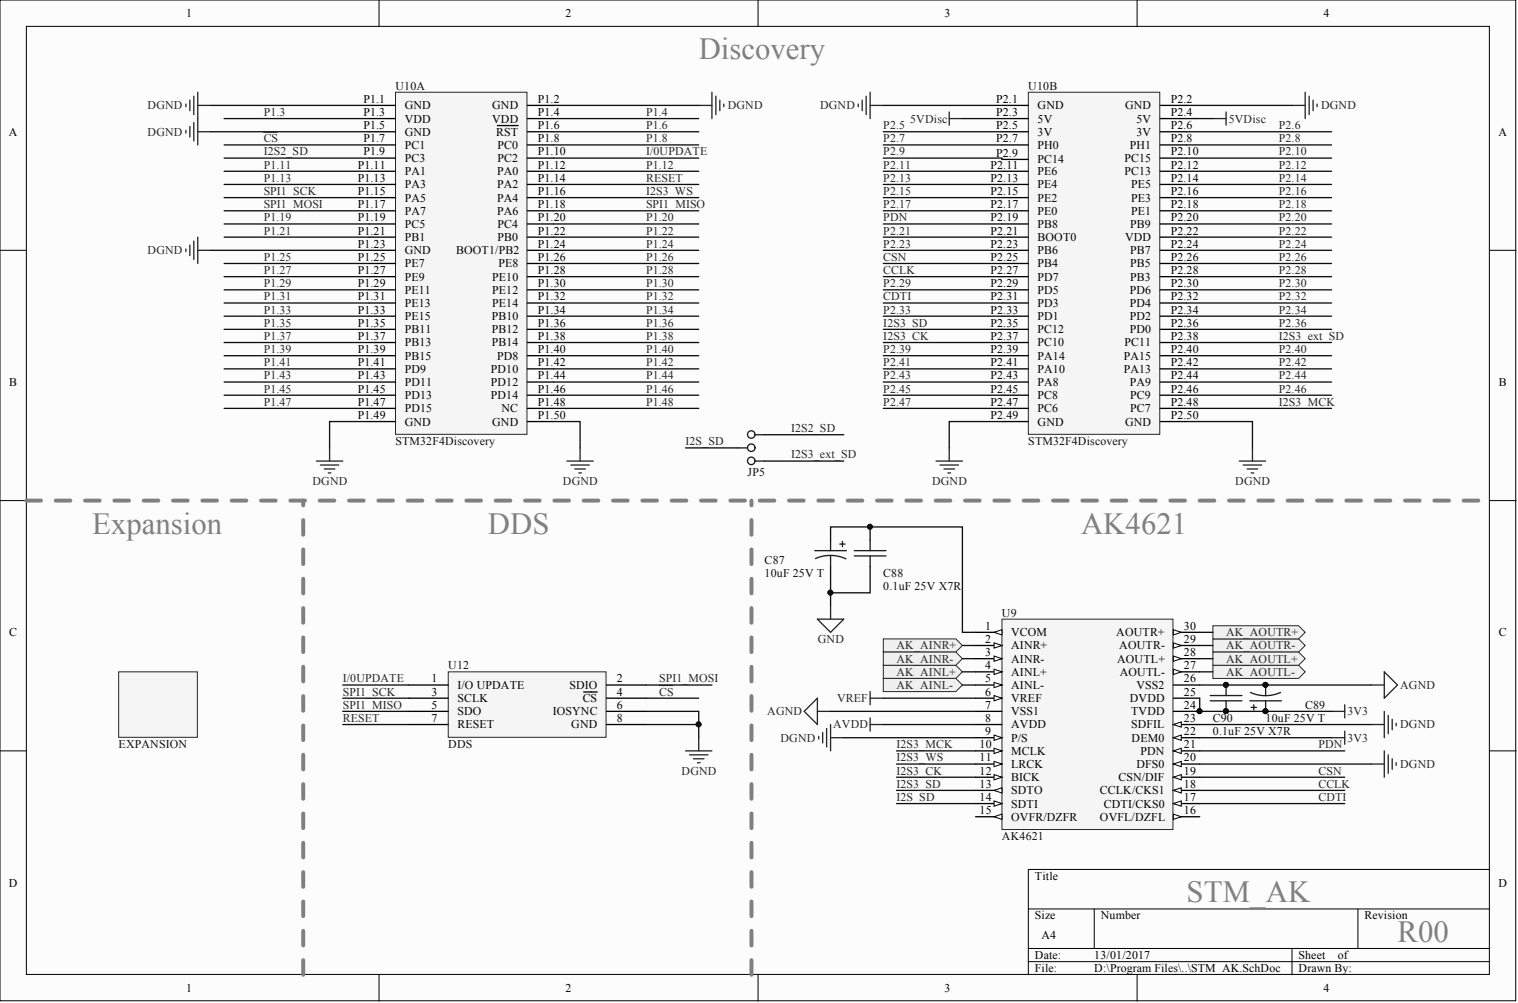
[picture p25: page 11]

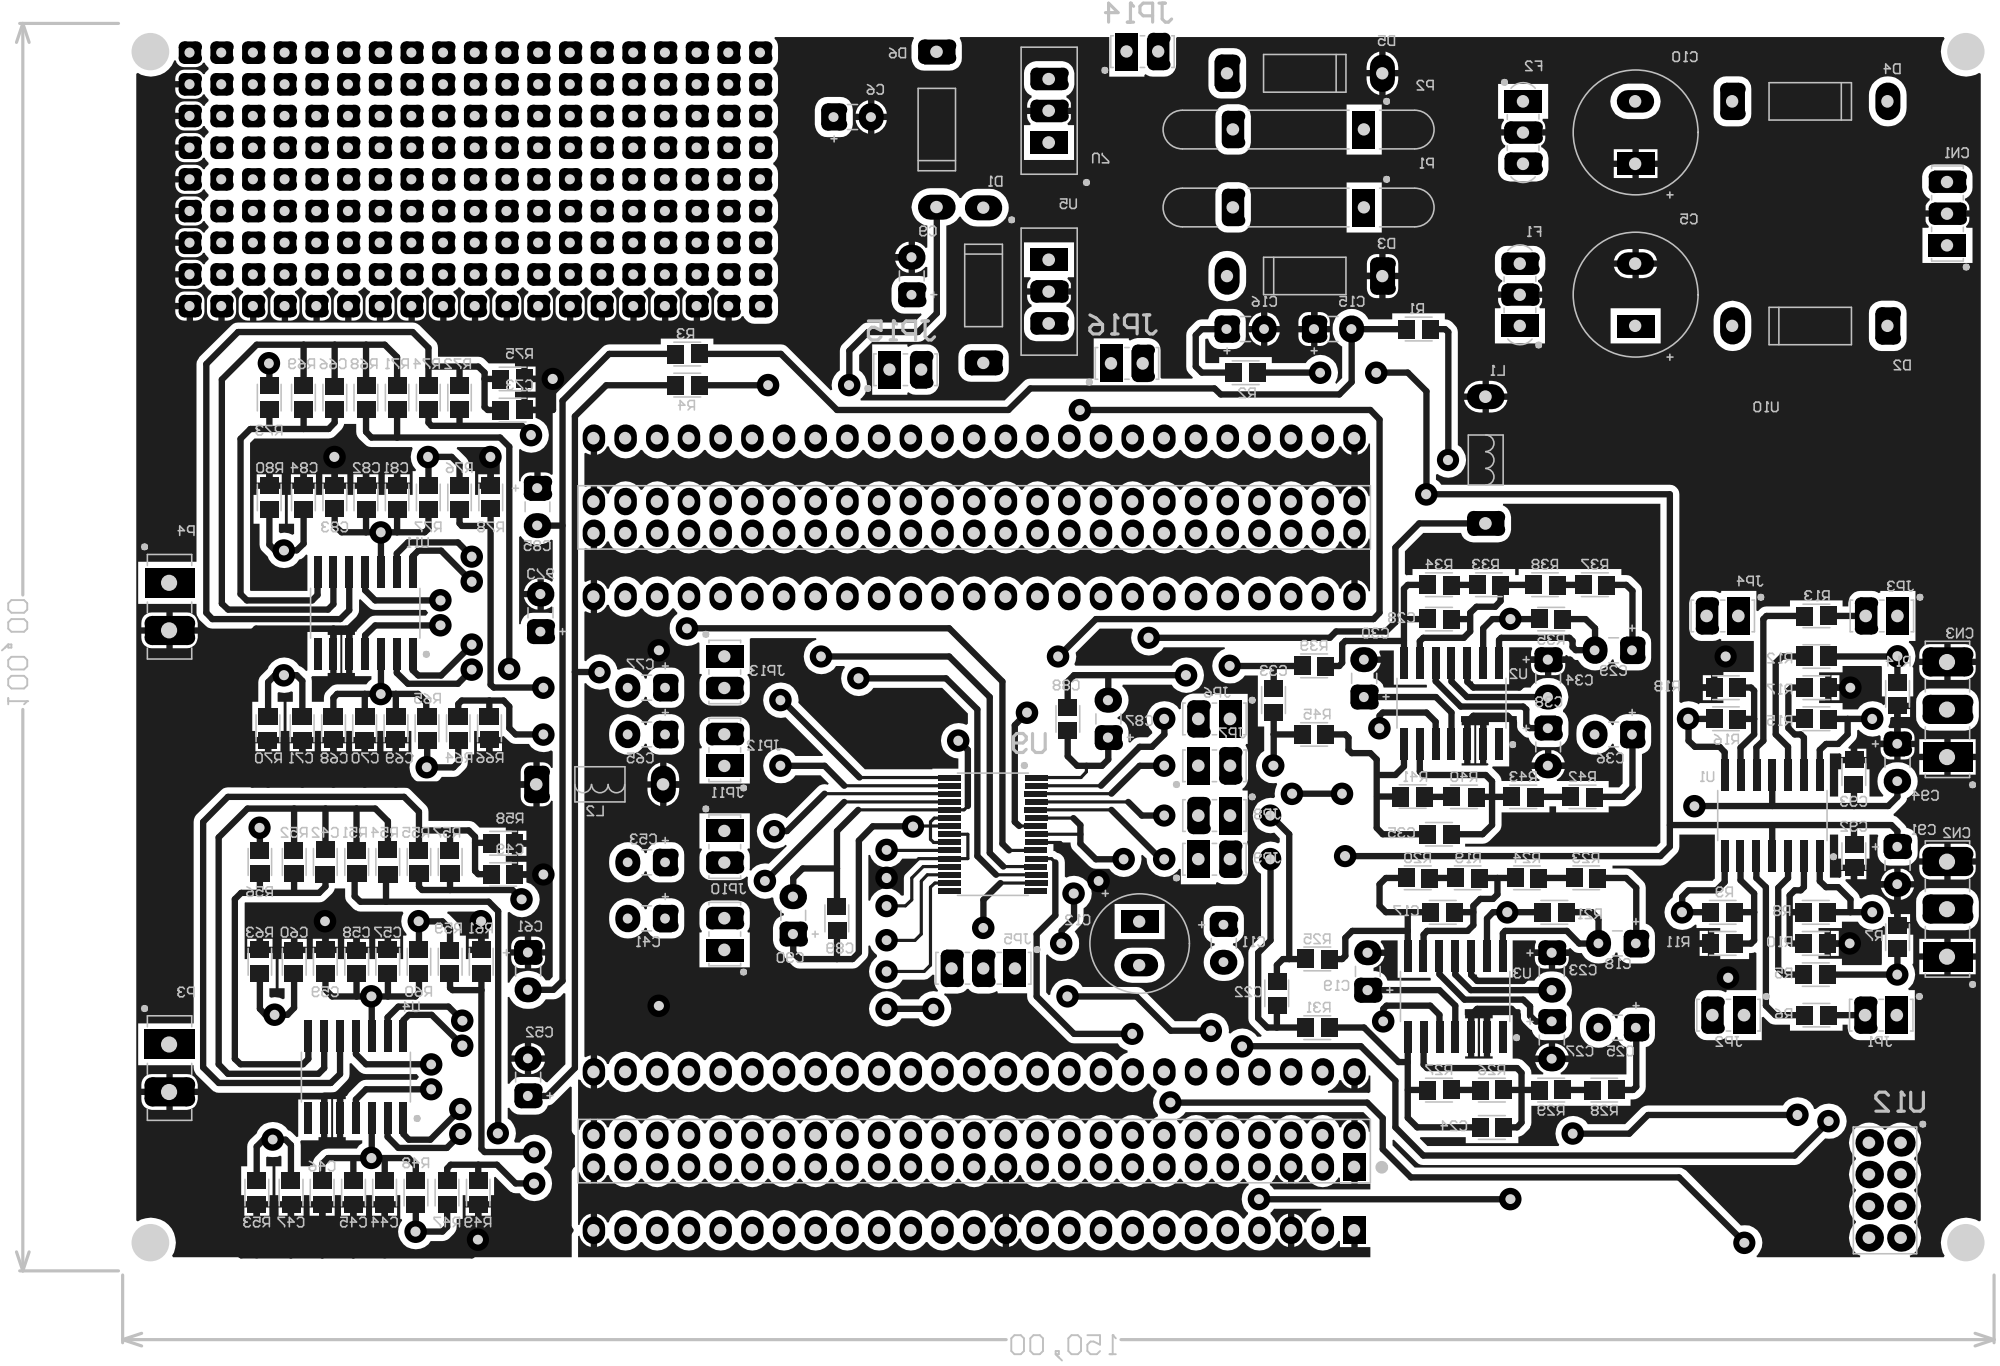
[picture p26: page 12]

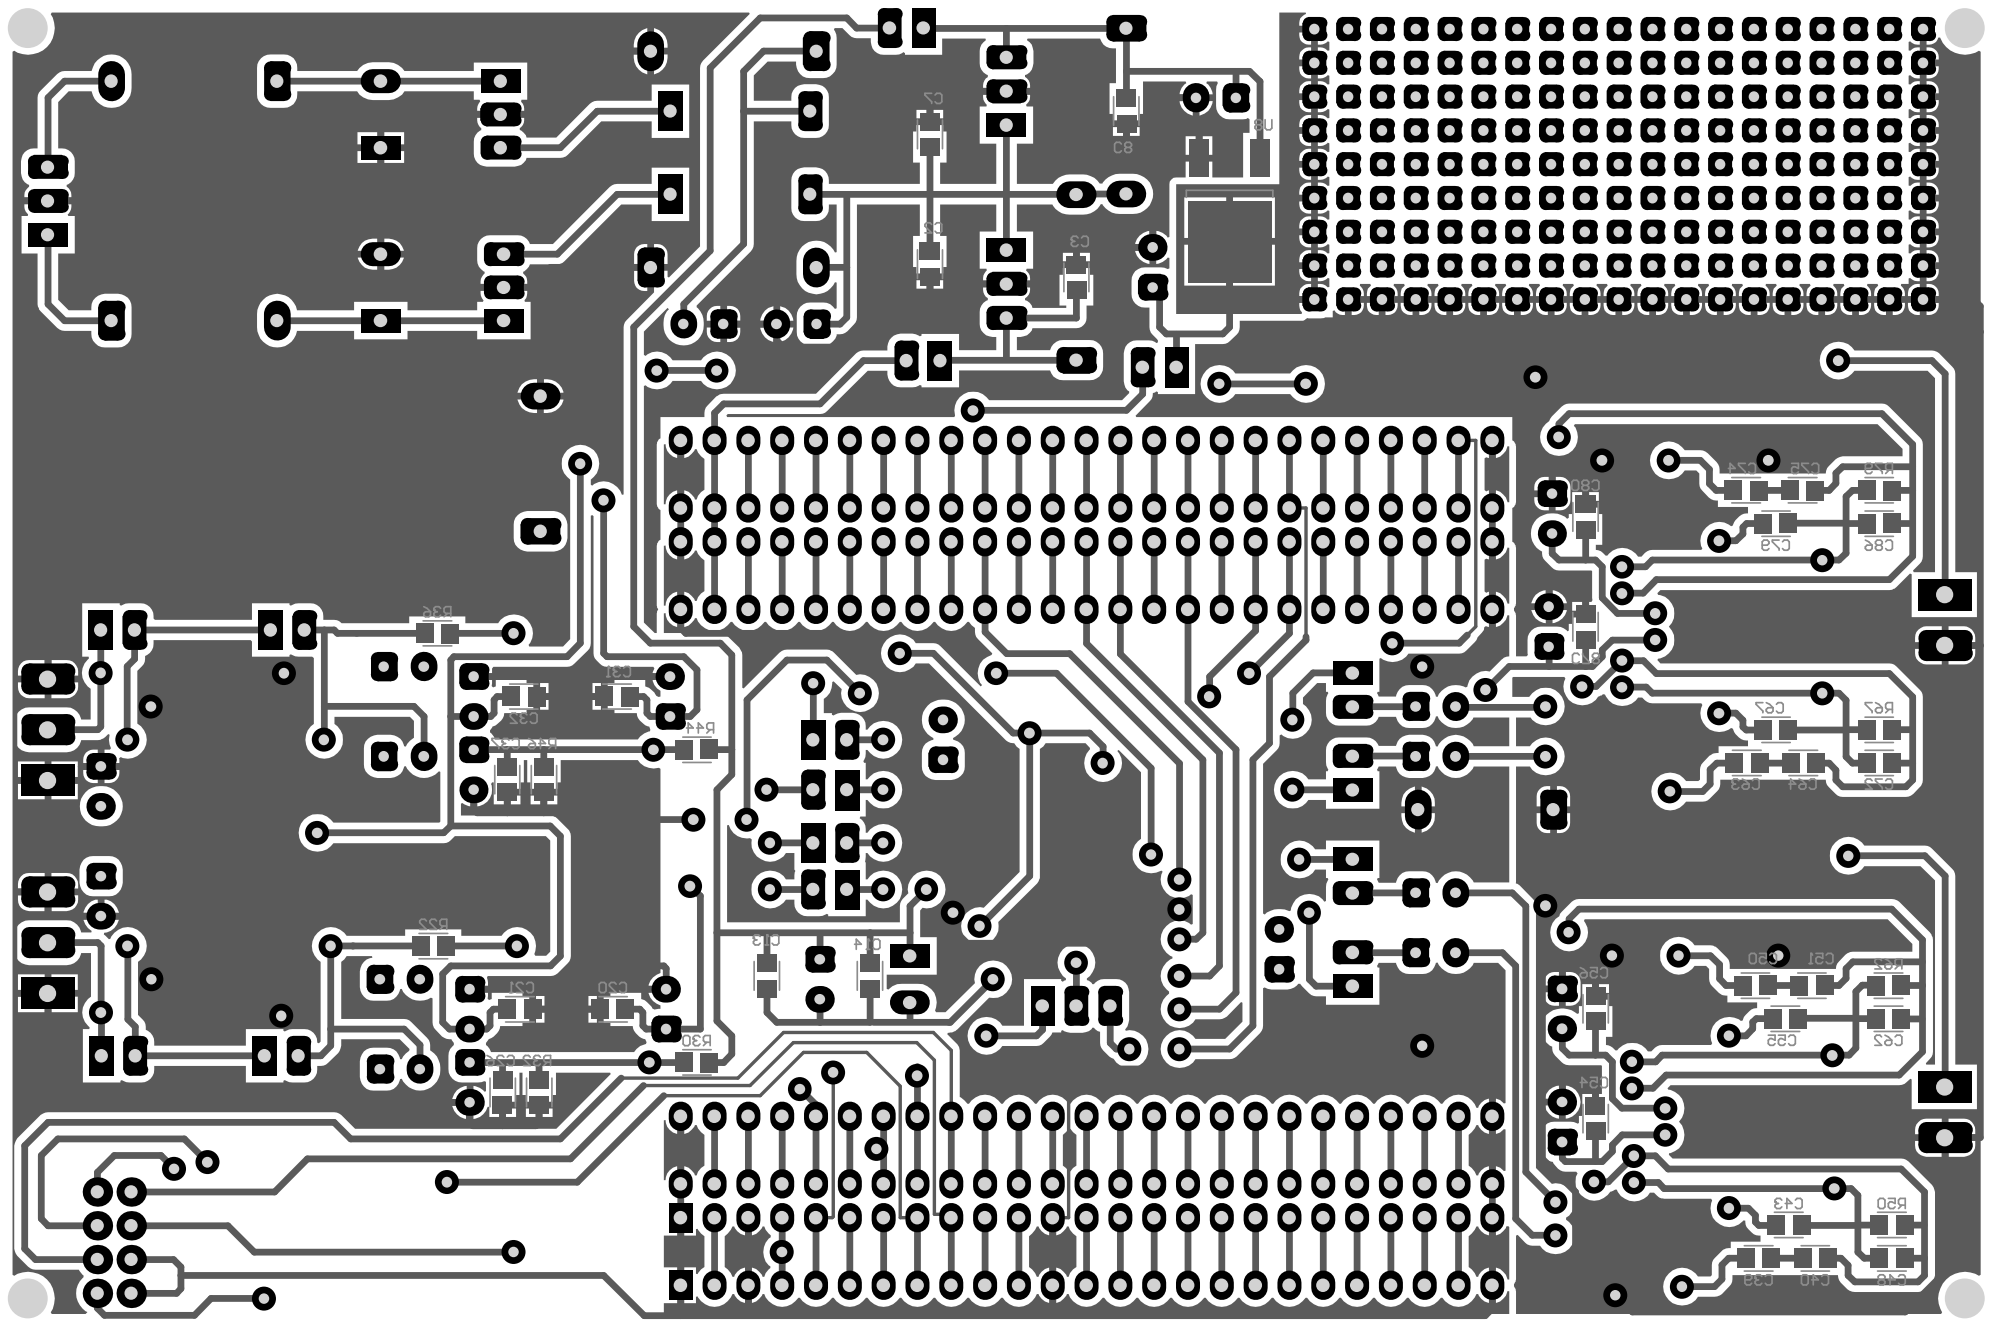
[picture p27: page 13]
