fdelconte/RadioInti_M4/(list of files, drawings)

Other design files:
HW/Fuentes.SchDoc
HW/GainCHL.SchDoc
HW/GainCHR.SchDoc
HW/INL.SchDoc
HW/Input.SchDoc
HW/INR.SchDoc
HW/OUTL.SchDoc
HW/Output.SchDoc
HW/OUTR.SchDoc
HW/Radios_Comunitarias.PcbDoc
HW/Radios_Comunitarias.PcbLib
HW/Radios_Comunitarias.PrjPcb
HW/Radios_Comunitarias.SchDoc
HW/Radios_Comunitarias.SchLib
HW/STM_AK.SchDoc
