fdelconte/RadioInti_M4/FM_transmitter/FM_transmitter.ioc

Mcu.UserName=STM32F407VGTx
PA0-WKUP.GPIO_Label=B1 [Blue PushButton]
PA0-WKUP.Signal=GPXTI0
PA10.GPIO_Label=OTG_FS_ID
PA10.Signal=USB_OTG_FS_ID
PA11.GPIO_Label=OTG_FS_DM
PA11.Signal=USB_OTG_FS_DM
PA12.GPIO_Label=OTG_FS_DP
PA12.Signal=USB_OTG_FS_DP
PA13.GPIO_Label=SWDIO
PA13.Signal=SYS_JTMS-SWDIO
PA14.GPIO_Label=SWCLK
PA14.Signal=SYS_JTCK-SWCLK
PA15.GPIO_Label=TEST_PIN
PA15.Signal=GPIO_Output
PA4.GPIO_Label=I2S3_WS [LRCK]
PA4.Signal=I2S3_WS
PA5.GPIO_Label=SPI1_SCK [SCL/SPC]
PA5.Signal=SPI1_SCK
PA6.GPIO_Label=SPI1_MISO [SDO]
PA6.Signal=SPI1_MISO
PA7.GPIO_Label=SPI1_MOSI [SDA/SDI/SDO]
PA7.Signal=SPI1_MOSI
PA9.GPIO_Label=VBUS_FS
PA9.Signal=USB_OTG_FS_VBUS
PB10.GPIO_Label=I2S2_CK [BICK]
PB10.Signal=I2S2_CK
PB2.GPIO_Label=BOOT1
PB2.Signal=GPIO_Input
PB3.GPIO_Label=SWO
PB3.Signal=SYS_JTDO-SWO
PB4.GPIO_Label=CSN
PB4.Signal=GPIO_Output
PB6.GPIO_Label=Audio_SCL
PB6.Signal=I2C1_SCL
PB8.GPIO_Label=PDN
PB8.Signal=GPIO_Output
PB9.GPIO_Label=Audio_SDA
PB9.Signal=I2C1_SDA
PC0.GPIO_Label=OTG_FS_PowerSwitchOn
PC0.Signal=GPIO_Output
PC10.GPIO_Label=I2S3_CK [BICK]
PC10.Signal=I2S3_CK
PC11.Signal=I2S3_ext_SD
PC12.GPIO_Label=I2S3_SD [SD_OUT]
PC12.Signal=I2S3_SD
PC14-OSC32_IN.GPIO_Label=PC14-OSC32_IN
PC14-OSC32_IN.Signal=RCC_OSC32_IN
PC15-OSC32_OUT.GPIO_Label=PC15-OSC32_OUT
PC15-OSC32_OUT.Signal=RCC_OSC32_OUT
PC3.GPIO_Label=I2S2_SD [SD_OUT]
PC3.Signal=I2S2_SD
PC7.GPIO_Label=I2S3_MCK [MCLK]
PC7.Signal=I2S3_MCK
PD12.GPIO_Label=LD4 [Green Led]
PD12.Signal=GPIO_Output
PD13.GPIO_Label=LD3 [Orange Led]
PD13.Signal=GPIO_Output
PD14.GPIO_Label=LD5 [Red Led]
PD14.Signal=GPIO_Output
PD15.GPIO_Label=LD6 [Blue Led]
PD15.Signal=GPIO_Output
PD3.GPIO_Label=CDTI
PD3.Signal=GPIO_Output
PD4.GPIO_Label=Audio_RST [RESET]
PD4.Signal=GPIO_Output
PD5.GPIO_Label=OTG_FS_OverCurrent
PD5.Signal=GPIO_Input
PD7.GPIO_Label=CCLK
PD7.Signal=GPIO_Output
PE1.GPIO_Label=MEMS_INT2 [INT2]
PE1.Signal=GPXTI1
PE3.GPIO_Label=CS_I2C/SPI [CS_I2C/SPI]
PE3.Signal=GPIO_Output
PH0-OSC_IN.GPIO_Label=PH0-OSC_IN
PH0-OSC_IN.Signal=RCC_OSC_IN
PH1-OSC_OUT.GPIO_Label=PH1-OSC_OUT
PH1-OSC_OUT.Signal=RCC_OSC_OUT
