fdelconte/RadioInti_M4/(commit log)

2016-09-15 agregadas las funciones para suma, resta y mult
2016-09-15 Proyecto comenzado con funciones de la libreria CMSIS e I2S.
2016-09-21 Mediciones de frecuencias de trabajo del periferico I2S.
2016-09-21 Agregado el History que te tira el Altium
2016-09-21 Agregada la placa desarrollada hasta el momento
    [Fuentes.SchDoc, INL.SchDoc, INR.SchDoc, Kornak-(STM32-Discovery-F4)-0001 Rev 1.01 Module Pinouts & Functions.xls, OUTL.SchDoc, OUTR.SchDoc, Radios_Comunitarias.PcbLib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]
2016-09-21 Agregado parte de los pines de configuracion del AK4621
    [STM_AK.SchDoc]
2016-09-22 Agregado 2 datasheets, de protocolo SPI y del DDS (AD9951) en capreta HW/Datasheets/
2016-09-22 cambiado algunos clocks y nombres del proyecto FM_transmitter desde el Cube (de codigo no se toco nada)
2016-10-13 git de mierda
2016-10-13 Pruebas de I2S mediante interrupciones.
2016-10-20 Avances realizados con I2S3. Half duplex TX OK. Full duplex TX sigue con problemas.
    [FM_transmitter.ioc, main.c]
2016-10-23 Agregados la mayoria de los footprints, quedan solo un par. Ademas, se puso una etapa por si necesitamos ganar a la entrada.
    [Fuentes.SchDoc, GainCHL.SchDoc, GainCHR.SchDoc, INL.SchDoc, INR.SchDoc, Input.SchDoc, OUTL.SchDoc, OUTR.SchDoc]
2016-10-31 Solo falta del Schematic los pines del DDS y ver que hacer con el PS del AK4621 que es entrada (lo clavaria a VCC y a la mierda)
    [Fuentes.SchDoc, GainCHL.SchDoc, GainCHR.SchDoc, INL.SchDoc, INR.SchDoc, Input.SchDoc, OUTL.SchDoc, OUTR.SchDoc]
2017-01-05 Se acomodaron y rutearon tanto los opamps de la entrada y ADC como la fuente y la discovery, resta por ver el DDS, los opamps del DAC y conectores. Mirar tambien los pines del DAC de salida, puede qu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
    [Fuentes.SchDoc, GainCHL.SchDoc, GainCHR.SchDoc, INL.SchDoc, INR.SchDoc, Input.SchDoc, OUTL.SchDoc, OUTR.SchDoc]
2017-01-06 Comunicacion I2S con DMA funciona para canal transmisor, usando I2S3. Probado a fs = 48KHz con palabras de 32bits en 32bits.
2017-01-09 Loopback usando los dos canales de I2S OK, tener en cuenta que fs = 48K.
2017-01-09 Loopback a fs = 48KHz funcionando, con los dos canales de I2S sincronizados.
2017-01-10 Practicamente terminado, faltaria agregar jumpers. Se modificaron algunos pines del I2S, como el SD y los de config que estaban pisando a unos importantes del STM
    [Fuentes.SchDoc, OUTL.SchDoc, OUTR.SchDoc, Radios_Comunitarias.PcbDoc, Radios_Comunitarias.PcbLib, Radios_Comunitarias.PrjPcb, Radios_Comunitarias.SchLib, STM_AK.SchDoc]
2017-01-11 Se agregaron los jumpers tanto en el ADC y DAC como en algunas alimentaciones (las mas importantes digamos)
    [Fuentes.SchDoc, INL.SchDoc, INR.SchDoc, OUTL.SchDoc, OUTR.SchDoc, Radios_Comunitarias.PcbDoc, Radios_Comunitarias.PcbLib]
2017-01-11 Se corrigio un GROUND que estaba feito, y se regenero el PDF de salida
    [Radios_Comunitarias.PcbDoc, Radios_Comunitarias.PrjPcb]
2017-01-12 Agrego disenio del filtro de 19KHz en Matlab.
2017-01-12 Pruebas realizadas por Pablo DA sobre el periferico I2S_EX, todavia no funciona.
2017-01-14 Pruebas exitosas de I2S_EX manejando 1 buffers y usando la funcion half complete callback para dividir el buffer en 2.
2017-01-17 Pruebas de doble buffer OK.
2017-01-18 Pruebas tratando de hacer andar el AK4621EF.
2017-01-19 Inicializacion fallida del periferico SPI.
2017-01-26 Pruebas sobre el codec. Funciona a fs = 192KHz. Loopback conectando SDO con SDI del codec anda sin problemas. El loopback utilizando el micro no funciona bien, debe ser por un problema de procesamien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
    [FM_transmitter.ioc, codec.c, main.c]
2017-01-26 Se quito la funcion bloqueante y el loopback utilizando el micro es constante. Hay que medir tiempos de procesamiento y verificar el manejo del dato, creo que eso ocasiona el ruido digital que tiene 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
2017-02-21 Loopback correcto, atenua la salida, hay que ver el estado de los filtros analogicos.
    [codec.c, codec.h, main.c]
2017-02-22 Suma de los dos canales funcionando.
2017-02-22 Pruebas de tiempos con todo el proceso salvo el filtrado, resulto bien.
2017-02-22 Version fabricada de la placa, hay que hacer modificaciones pero no son muchas (SPI y hay unos cables de I2S que estan al reves, el de entrada y salida)
    [Radios_Comunitarias.PcbDoc, Radios_Comunitarias.PcbLib, Radios_Comunitarias.PrjPcb, Radios_Comunitarias.SchLib, STM_AK.SchDoc]
2017-02-22 Problemas con el punto fijo.
    [codec.c]
2017-02-23 Ultimas pruebas con tipo de dato float.
2017-02-25 MPX andando. Nuevas frecuencias de trabajo (fs = 152 KHz, I2S_clk = 154.1818 MHz, System_clk = 122.1818 MHz) que permiten que los pilotos se acerquen mucho mas al valor deseado.
