fdelconte/RadioInti_M4/(notices)

Notices in the files:
FM_transmitter/Src/main.c:
(C) COPYRIGHT STMicroelectronics *****END OF FILE
